Tome-Sulmont/docs-site/README.md

# Tomé Docs

Here is my documentation website where I share the various projects I am working on.

[docs.tomesulmont.com](https://docs.tomesulmont.com/)

I write my documentation with [Obsidian](https://obsidian.md/) and use [Quartz 4](https://quartz.jzhao.xyz/) to publish it.
