Tome-Sulmont/docs-site/content/B4 Adapter Project/Related Pages/Lens Pinout.md

---
draft: false
---

| B4 lens pinout | Female 12 pin HIROSE |
| :--- | --- |
| `1` RET switch<br>`2` VTR trigger<br>`3` GND<br>`4` Lens Auto/Manual control<br>`5` Iris control<br>`6` +12 V DC<br>`7` Iris position<br>`8` Iris A/R input<br>`9` Extender (doubler) position<br>`10` Zoom position<br>`11` ---<br>`12` --- | ![[HIROSE_12pin_connector_only.jpg\|12 pin hirose connector pinout\|260]] |

>**Note:**
>The pinout is standard for all manufacturers (Fujinon and Canon)

Source: [SteadicamForum](https://steadicamforum.com/index.php?app=forums&module=forums&controller=topic&id=151)
