Tome-Sulmont/docs-site/content/index.md

---
title: Welcome
description: Documentation of my camera, optics and maker projects. From adapting B4 broadcast lenses, to gear repairs and DIY builds.
draft: false
---
On this website, I share the various projects I am working on. 

## Projects
>### [[B4 Adapter Documentation]]
>A detailed guide on how to make an optically corrected adapter that lets 2/3" B4 broadcast lenses work on Sony, Nikon, Canon, Fujifilm and Lumix mirrorless cameras.

## Repairs
>### [[Zoom F6 NP-F Replacement]]
>A 3D-printable replacement for the Zoom F6 NP-F battery holder. STL and STEP files, as well as print settings, are included.
