Tome-Sulmont/docs-site/content/B4 Adapter Project/Tempo B4.md

---
draft: true
---
Local build :
```
npx quartz build --serve
```

GitHub deployment :
```
npx quartz sync
```

To Do :
- [x] Photo of the real adapter
- [ ] Voir B4-Adapter-Claude-Expertise pour améliorer
- [x] Photo of the rig
- [x] Assembly picks
- [x] increase the mount tol on the 3d
- [ ] Ironing (degrease tol ??)
- [x] Why adapting B4 broadcast glass in the first place ?
- [ ] Practical result
- [x] personal setups
- [x] r/Filmmakers, r/videography, r/DIY
- [ ] SD / HD lenses topic
- [x] Google indexation CEO -> *Automatic*
- [ ] ENG keyword
- [ ] Fuji HAF’s b4 cine lenses
- [ ] Comparison w/ and without the optical element

## Print advice section ?

As you know, every printer is different

I can't advise you enough to check if the tolerances are good by printing section of the part

Test you can do :

The bore hole that 
The circular alu
the size of the hole heat inserts

---
I'm a filmmaker. When I can't find the gear I need — or when it breaks — I build it, and I document how here. Everything on this site is something I made and actually use.
