Tome-Sulmont/docs-site/content/B4 Adapter Project/B4 Adapter Documentation.md

---
draft: false
description: Comprehensive guide on how to adapt 2/3" B4 ENG broadcast lenses to any mirrorless camera using corrective optics.
---

Here is a comprehensive guide on how to adapt 2/3" B4 broadcast lenses to any mirrorless camera using corrective optics. 

This adapter can be built for virtually any mounts available on the market (Sony, Nikon, Canon, Fujifilm, Lumix…) and can be made for relatively cheap compared to the off-the-shelf options available on the market.

## Context

B4 lenses are designed for use with 3-CCD sensors. In order to adapt them correctly to modern single-sensors, an optical element is required to correct [[Spherical Aberration]].

After quite a bit of research, I found that the [Blackmagic B4 mount](https://www.blackmagicdesign.com/products/blackmagicursaminipro/techspecs/W-URSA-22) for the URSA Mini can be found at a relatively low cost compared to the other [[Adapter options]] available to us.

The idea is to combine the Blackmagic B4 mount and a lens mount (salvaged from a lens adapter) with a 3D-printed part.

| ![[Blackmagic_URSA_mini_b4-mount.jpg\|Blackmagic URSA Mini B4 mount\|280]] | ![[Lens_mount_from_lens_adapter.jpg\|Lens mount from lens adapter\|110]] |
| :---: | :---: |
| *URSA Mini B4 mount* | *Lens adapter* |

See [[B4 Lens Nomenclature]] to learn about the naming system and how to choose the right B4 lens.
And see [[Why Adapting B4 Broadcast Lenses]] for a list of pro and cons of broadcast lenses.

## Capabilities

- APSC coverage (with the doubler engaged)
- `3.8x` crop factor (FF equivalent)
- No spherical aberration; the lens can be used wide open.

See [[Additional Information]] for more details.

## The Design

| ![[Final_adapter_front.jpg\|Custom adapter\|300]] | ![[Adapter_on_B4_lens_zoom.jpg\|Custom adapter mounted on a B4 lens\|300]] |
| :---: | :---: |
| *The final adapter* | *Here it is mounted on a B4 lens* |

### CAD

| ![[CAD_Assembly_with_balloon.png\|CAD isometric view\|340]] | ![[CAD_Assembly_section_view.png\|CAD section view\|235]] |
| :---: | :---: |
| *Isometric view* | *Side section view* |

➀ : URSA Mini B4 Mount [.STEP ↓](./B4-Adapter-Project/download/URSA-Mini-B4-Mount.STEP)
➁ : 3D-printed part [.STEP ↓](./B4-Adapter-Project/download/3d-printed-part.STEP)
③ : Aluminium lens mount [.STEP ↓](./B4-Adapter-Project/download/alu-lens-mount.STEP)

The [[Flange Distance]] of the URSA removable mount is 32.3mm. If you are interested, here is how I determined the [[URSA Removable Mount Flange Distance]].
I designed the part around this value and the different components listed in the BOM below.

## How to Build

### 3D Print the Part

Download the [.STL ↓](./B4-Adapter-Project/download/3d-printed-part.STL) , the [.STEP ↓](./B4-Adapter-Project/download/3d-printed-part.STEP) or directly the [.3MF ↓](./B4-Adapter-Project/download/3d-printed-part.3mf) file.

I printed the part in ASA on a Bambu Lab P1S printer.
Why ASA? Mainly for its UV and heat resistance, as well as its adequate mechanical properties.

Find all my [[Adapter Print Recommendations]] here.

### Bill of Materials

| Category | Item | Ref | Brand | Qty | Link |
| --- | --- | --- | --- | --- | --- |
| Mount (choose yours) | Leica M to **Fuji X** | LM-FX | PHOLSY | 1 | [Link](https://www.amazon.fr/PHOLSY-Adaptateur-objectifs-Leica-Appareil/dp/B0C9HVQCYR) |
| | Leica M to **Sony E** | LM-E | PHOLSY | 1 | [Link](https://www.amazon.fr/-/en/PHOLSY-Manual-Lens-Adapter-Compatible/dp/B0CYT475DR/) |
| | Leica M to **L mount**  | LM-L | PHOLSY | 1 | [Link](https://www.amazon.fr/-/en/PHOLSY-Adapter-Leica-Voigtlander-Compatible/dp/B0C9J2FF3T) |
| | Leica M to **Nikon Z**  | LM-N/Z | PHOLSY | 1 | [Link](https://www.amazon.fr/-/en/PHOLSY-Adapter-Compatible-Voigtlander-Cameras/dp/B0C16Y1WQF?th=1) |
| | Leica M to **MFT** | LM-MFT | PHOLSY | 1 | [Link](https://www.amazon.fr/-/en/Adapter-Leica-Cameras-Compatible-Panasonic/dp/B0C9HM25KZ) |
| | Leica M to **EOS-M** | LM-EOSM | PHOLSY | 1 | [Link](https://www.amazon.fr/-/en/Leica-Adapter-Compatible-Voigtlander-VM-Mount/dp/B0CJLNGM32) |
| | Leica M to **Canon RF** | LM-RF | PHOLSY | 1 | [Link](https://www.amazon.fr/-/en/PHOLSY-Adapter-Compatible-Leica-Voigtlander/dp/B0C16YNX2Z) |
| | | | | | |
| Corrected B4 adapter | URSA Mini B4 Mount | CINEURSAMUPROTB4HD | Blackmagic | 1 | [Link](https://www.blackmagicdesign.com/products/blackmagicursaminipro/techspecs/W-URSA-22) |
| | | | | | |
| Screws and bolts | M1.6 x 5mm Torx Screw | ISO14580 M1.6 x 5mm | | 4 | [Link](https://fr.aliexpress.com/item/1005005980400627.html) |
| | M1.6 Washer | DIN9021 M1.6 x 4 x 0.3 | | 4 | [Link](https://fr.aliexpress.com/item/1005007625630719.html) |
| | M2.5 Heat Insert | M2.5 x L4 x OD4 | | 5 | [Link](https://fr.aliexpress.com/item/1005008887061865.html) |
| | 1/4-20 Heat Insert | 1/4-20 x 6mm | | 2 | [Link](https://fr.aliexpress.com/item/1005008959101729.html) |

> **Disclaimers:** 
> Please note that the current design only works with the Leica M adapters listed above. 
> I have only tested the Fuji X and the Sony E version, but the design of all listed adapter is identical. So it should work with the other as well.

>**Tips to find the Blackmagic B4 adapter:** 
>Buy it from the second-hand market.
>Search the adapter by its reference *"CINEURSAMUPROTB4HD"*.

### Assembly

1. Print the part.

![[3D-Printed_part.jpg|3D-printed part|200]]

2. Remove the tree support. The surface is not functional but ensure no support material remains.

![[Remove_tree_support.jpg|Support material removal|200]]

3. Install the `x5` **M2.5 heat inserts** with a soldering iron. Be meticulous, the insert must be perfectly straight.

![[M2.5_heat_insert.jpg|M2.5 heat insert installation with a soldering iron|200]]

4. Repeat the operation with the `x2` **1/4-20 heat inserts**.

![[1_4-20_heat_insert.jpg|1/4-20 heat insert installation with a soldering iron|200]]

5. Disassemble the Leica M adapter and keep only the black coated aluminium mount.

![[Disassemble_Leica-M_adapter.jpg|Leica M adapter disassembly|400]]

6. Attach the aluminium mount to the printed part using `x4` **M1.6 screws and washers**. Align the red dot upward.

![[red_dot_up_cercle.jpg|Mirrorless mount orientation|200]] ![[Attach_the_aluminium_mount.jpg|Screwing the mirrorless mount in place|200]]

7. Remove the plastic protrusion on the side of the URSA Mini B4 mount.

8. Attach the URSA Mini B4 mount to the printed part using the included `x5` **M2.5 x 12 mm screws**. Align the notch upward (not necessarily the red dot).

![[noch_up_cercle.jpg|URSA B4 mount orientation|200]] ![[Attach_the_URSA_Mini_B4.jpg|Screwing the URSA B4 mount in place|200]]

9. The adapter is now complete.

![[Final_adapter_back.jpg|Completed adapter|200]]

## Lens / Adapter Support

The B4 mount is designed for use on heavy cameras, therefore, the connection between the lens and the adapter is extremely strong. 
However, mirrorless mounts are not designed to handle this amount of weight. 

### You have 3 options

1. **Hanging camera**
If you are using a mirrorless, the mount is strong enough to hang the camera from the mount. However, be careful: do not hold the grip of the camera to move the lens around, hold the lens instead. When using a tripod, mount the adapter directly to it.

2. **Solid connection**
Create a solid connection between the adapter and the camera body.
You can attach an Arca Swiss plate under the custom adapter. By using another Arca plate, 2 clamps and a 3D-printed riser, you can securely connect the adapter to the camera body.

3. **Lens support**
I've seen people online using lens supports and rods, this is another option.
Note that there is no need for an additional "lens support" as long as the adapter is strongly connected to the camera (option 2).

I use both Option 1 & 2 depending on the shoot. 
My current personal setup looks something like this :

| ![[personal_setup_solid_connection.jpg\|B4 ENG broadcast lens adapted on a mirrorless camera\|378]] | ![[solid_connection_only.jpg\|Custom adapter to camera body linkage\|294]] |
| :---: | :---: |
| *Option 2: solid connection* | *Plate, clamp and riser systeme* |

## Powering the rocker

The rocker on the side of the lens can be used to perform smooth and slow zooms. To use it, the rocker must be powered.
Pre-made cable exist but there are quite expensive. If you know how to make your own cable, it's worth it.

The cable attached to the lens use a male 12-pin HIROSE connector. You therefore need the female HIROSE connector and a 12 V power source. Use the pinout below to wire your cable.

### Female 12-pin HIROSE pinout

![[HIROSE_12pin_connector_only.jpg|12 pin hirose connector pinout|180]]
`3` = GND
`6` = +12 V DC

Because this information can be difficult to find, here is the detailed [[Lens Pinout]].

I advise you to buy the **female 12pin HIROSE** from AliExpress. They are available in both socket and plug version (make sur to select the female connector).

For the power source, you can use an NP-F battery plate that have a 12V output, such as those from SmallRig ([# 3018](https://www.smallrig.com/global/smallrig-np-f-battery-adapter-plate-lite-3018.html) or [# 3168B](https://www.smallrig.com/global/SmallRig-NP-F-Battery-Adapter-Mount-Plate-Advanced-Edition-3168B.html)). Alternatively you can use a D-Tap plug if you are using V-Lock batteries.

## Remaining Issues 

### Concentricity

The tolerances of the FDM 3D-printing process do not allow for "perfect" concentricity.
This can result in the lens not zooming perfectly to the center of the frame. In practice, this issue is barely noticeable and not disturbing in most cases. Just be aware this exists.

## Sample footages

If you want to see the adapter in action, check out my [[Canon J16ax8B4 Review]].

## Thanks

Thanks for reading this article, I hope you found some useful information.

I would love to discuss the topic and see if you're building one yourself.
