Tome-Sulmont/docs-site/content/B4 Adapter Project/Reddit post.md

---
draft: true
---

r/Filmmakers 
r/videography
r/VintageLenses
r/cinematography
r/VIDEOENGINEERING

# Reddit Adapter

### Custom B4 lens adapter for mirrorless cameras (with corrective optics)

Have you ever wondered how to adapt 2/3" B4 broadcast lenses to mirrorless camera?

Right now, you basically have two options: 
- Buy an insanely expensive corrected adapter
- Or use a simple pass-through adapter that forces you to stop the lens way down to avoid aberrations

But what if I told you there was a third option…

Jokes aside, for the past year and a half, I've spent way too much time designing a DIY adapter that works with any mirrorless mount currently available on the market (Sony, Nikon, Canon, Fujifilm & Lumix) — and, more importantly, includes the proper corrective optical element. 

The key idea is using the **URSA Mini B4 mount from Blackmagic** (which already contains the optical element) and adapting it mechanically to mirrorless mounts via a custom 3D-printed part and a metal mount.

I documented the entire process — optical considerations, flange distance measurements, 3D-printing, assembly, and more — here:

→ [B4 Adapter Documentation](https://docs.tomesulmont.com/B4-Adapter-Documentation)

I'd be more than happy to answer questions and hear your feedback :)

--- 

### Custom B4 lens adapter (with proper corrective optics)

Ever wondered how to properly adapt 2/3" B4 broadcast lenses to mirrorless cameras?

Your options today are either absurdly expensive corrected adapters, or a cheap pass-through adapter that forces you to stop down hard to avoid aberrations.

For the past year and a half, I've spent way too much time designing a third option: a DIY B4 adapter compatible with basically any mirrorless mount (Sony, Nikon, Canon, Fujifilm & Lumix).

The key idea is using the **URSA Mini B4 mount from Blackmagic** (which already contains the optical element) and adapting it mechanically to mirrorless mounts via a custom 3D-printed part and a metal mount.

I wrote a full guide covering the optics, measurements, 3D printing, and assembly. It might be useful if you’re into broadcast/ENG glass or love to adapt unique lenses.

→ [B4 Adapter Documentation](https://docs.tomesulmont.com/B4-Adapter-Documentation)

I will be more than happy to answer questions and hear your feedback :)

---

# Reddit Canon J16ax8B4

### Testing a B4 Lens on a Mirrorless Camera (Sample Images)
### What a B4 Broadcast Lens Looks Like on a Mirrorless Camera

I recently shared my custom B4 broadcast lens adapter [here](https://www.reddit.com/r/videography/comments/1qxd3kj/comment/o4511nf/), and several people asked to see **sample images** captured with it. 

I conducted some tests and created an article that includes interactive viewers allowing you to directly compare different apertures and focal lengths.

You can find my test of the Canon J16ax8B4 lens here:

→ [Canon J16ax8B4 Review](https://docs.tomesulmont.com/Canon-J16ax8B4-Review)

I’m trying to build the kind of resource I wish had existed when I first got interested in B4 lenses.  

I’d love to hear your feedback :)

**PS:** Yes, some tests were done in my bathroom. I needed the length of the corridor plus the bathroom.

---

Disclaimer: this is still an option that cost some money and some manufacturing knowledge

The few component needed can be found for cheap on AliExpress.
The main issue is sourcing the URSA B4 mount. I found mind on the second hand market; you can also search it by its reference "CINEURSAMUPROTB4HD" you may found cheaper resellers.

This isn’t meant to replace commercial solutions, but it can makes working with B4 glass on mirrorless bodies far more accessible.

Tell me what you thinks and want to see next :)

---

Hello documentary enthusiast, if you are interested in re-using your old B4 ENG/broadcast lenses, I designed a custom adapter for mirrorless mounts.

It uses a corrective optic from the URSA Mini B4 mount to deal with the lack of a 3-CCD prism.

I documented the entire making process if you're interested:
https://docs.tomesulmont.com/B4-Adapter-Documentation

Hello, I seen discussions about adapting B4 lenses here.

I designed a custom adapter for mirrorless mount. It uses a corrective optic from the URSA Mini B4 mount to deal with the lack of a 3-CCD prism.

I documented the entire making process if you're interested:
https://docs.tomesulmont.com/B4-Adapter-Documentation

It uses a corrective optic from the URRA Mini B4 mount to deal with the lack of 3-CCD prisme.
In combinaison with a metal mount and a 3d-printed part, it's create a relatively inexpensive option.
