Tome-Sulmont/docs-site/content/B4 Adapter Project/Related Pages/Spherical Aberration.md

---
draft: false
---

Lenses made for 3-CCD sensor focus different colours at different depths because the optical path of red, green and blue through the prisms is different. B4 lenses are designed to compensate for this effect.

Spherical aberration occurs when B4 optics are used with sensors using the Bayer filter.

| ![[Schematic_prism-based_3-CCD_sensor.jpg\|3-CCD sensor schematic\|340]] | ![[Bayer_matrix_sensor.jpg\|Sensor with Bayer filters chematic\|300]] |
| :---: | :---: |
| *3-CCD sensor schematic* | *Sensor w/ Bayer filter* |

Spherical aberration ≠ Chromatic aberration
Chromatic aberration is not corrected by the corrective optics (the green & purple fringing remains visible)

>**Note:**
>Engaging the doubler corrects some amount of spherical aberration, but not all of it.
