Tome-Sulmont/docs-site/content/B4 Adapter Project/Related Pages/Adapter options.md

---
draft: false
---

## My pick

- [Blackmagic URSA Mini B4 Mount](https://www.blackmagicdesign.com/products/blackmagicursaminipro/techspecs/W-URSA-22) (corrected x1.1)

## Other options that I came across (MFT, Sony E, PL, RED...)

- [KIPON B4 to PL S35](https://kipon.com/product/b4pl-s35/) (corrected x2.9)
- [Fotodiox Pro B4 to MFT](https://fotodioxpro.com/products/b4-magic) (corrected x1.4)
- [IB-E HDx35 B4 to PL](https://ibe-shop.com/products/hdx35-mark-iii-converter) (corrected)
- [Sony LA-EB1 B4 to E](https://pro.sony/en_ML/products/camera-lenses/la-eb1) (corrected)
- [MTF](https://mtfservices.com/collections/lens-adaptors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) offers a wide range of options (magnification only, no correction)
- [Zhongyi B4 to MFT](https://www.stkb.jp/shopdetail/000000001426/) (no correction x2)
- [Cinelux B4 to RED DSMC2](https://shop.cinelux.co.uk/products/b4-to-red-dsmc1-2-mount-adapter?_pos=1&_sid=8adc13e9a&_ss=r) (corrected x1.1)
- [Multicam B4 to MFT](https://www.multicam.systems/product/multicam-systems-b4-2-3-to-mft-adapter/) (corrected x1.1)

## James and Camera adapter

James and Camera is putting great content on B4 optics.
He has tested a lot of B4 lens (with and without corrected adaptors).
He is also selling a B4 adapter to various mount (Sony E, PL…).

Source: [James and Camera channel](https://www.youtube.com/@jamesandcamera)
