Tome-Sulmont/docs-site/content/B4 Adapter Project/Related Pages/Reddit post.md

---
draft: true
---

# Custom B4 lens adapter for mirrorless cameras (with corrective optics)

Have you ever wondered how to adapt 2/3" B4 broadcast lenses to mirrorless camera?

Right now, you basically have two options: 
- Buy an insanely expensive corrected adapter
- Or use a simple pass-through adapter that forces you to stop the lens way down to avoid aberrations

But what if I told you there was a third option…

Jokes aside, for the past year and a half, I've spent way too much time designing a DIY adapter that works with any mirrorless mount currently available on the market (Sony, Nikon, Canon, Fujifilm & Lumix) — and, more importantly, includes the proper corrective optical element. 

The key idea is using the **URSA Mini B4 mount from Blackmagic** (which already contains the optical element) and adapting it mechanically to mirrorless mounts via a custom 3D-printed part and a metal mount.

I documented the entire process — optical considerations, flange distance measurements, 3D-printing, assembly, and more — here:

→ [B4 Adapter Documentation](https://docs.tomesulmont.com/B4-Adapter-Documentation)

I'd be more than happy to answer questions and hear your feedback :)

--- 

# Custom B4 lens adapter (with proper corrective optics)

Ever wondered how to properly adapt 2/3" B4 broadcast lenses to mirrorless cameras?

Your options today are either absurdly expensive corrected adapters, or a cheap pass-through adapter that forces you to stop down hard to avoid aberrations.

For the past year and a half, I've spent way too much time designing a third option: a DIY B4 adapter compatible with basically any mirrorless mount (Sony, Nikon, Canon, Fujifilm & Lumix).

The key idea is using the **URSA Mini B4 mount from Blackmagic** (which already contains the optical element) and adapting it mechanically to mirrorless mounts via a custom 3D-printed part and a metal mount.

I wrote a full guide covering the optics, measurements, 3D printing, and assembly. It might be useful if you’re into broadcast/ENG glass or love to adapt unique lenses.

→ [B4 Adapter Documentation](https://docs.tomesulmont.com/B4-Adapter-Documentation)

I will be more than happy to answer questions and hear your feedback :)

---

r/Filmmakers (more serious than r/videography)
r/VintageLenses
r/cinematography
r/VIDEOENGINEERING

To Do :
- [x] Photo of the real adapter
- [x] Photo of the rig
- [x] Assembly picks
- [x] increase the mount tol on the 3d
- [ ] Ironing (degrease tol ??)
- [x] Why adapting B4 broadcast glass in the first place ?
- [ ] Practical result
- [ ] personal setups ??
- [ ] r/Filmmakers, r/videography, r/DIY
- [ ] SD / HD lenses topic
- [ ] Google indexation CEO
- [ ] ENG keyword
- [ ] Fuji HAF’s b4 cine lenses

---

Disclaimer: this is still an option that cost some money and some manufacturing knowledge

The few component needed can be found for cheap on AliExpress.
The main issue is sourcing the URSA B4 mount. 
I found mind on the second hand market; you can also search it by its reference "CINEURSAMUPROTB4HD" you may found cheaper resellers.

This isn’t meant to replace commercial solutions, but it can makes working with B4 glass on mirrorless bodies far more accessible.

![[personal_setup_solid_connection.jpg|500]]

![[Final_adapter_front.jpg|300]]

![[Adapter_on_B4_lens_zoom.jpg|300]]
![[CAD_Assembly_with_balloon.png|300]]
![[CAD_Assembly_section_view.png|300]]
