Tome-Sulmont/docs-site/content/B4 Adapter Project/attachments/1_4-20_heat_insert.jpg

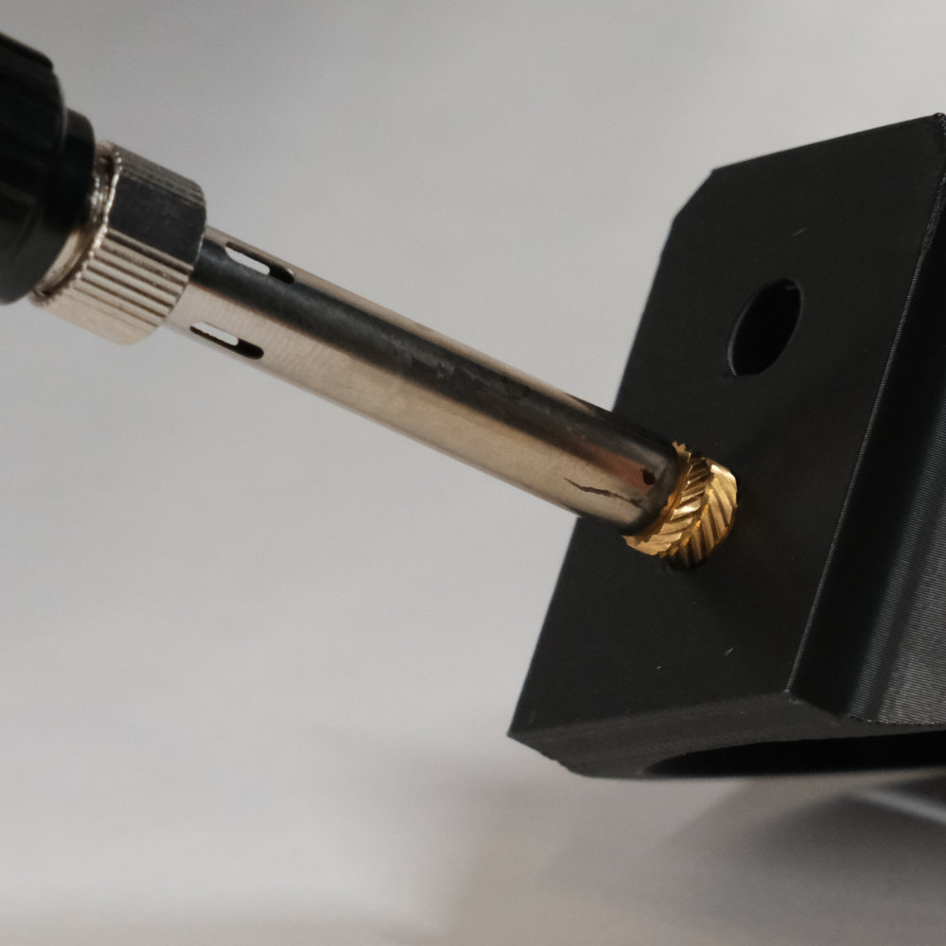
content/B4 Adapter Project/attachments/1_4-20_heat_insert.jpg
