Tome-Sulmont/docs-site/content/B4 Adapter Project/attachments/2_3inch_APSC_coverage.png

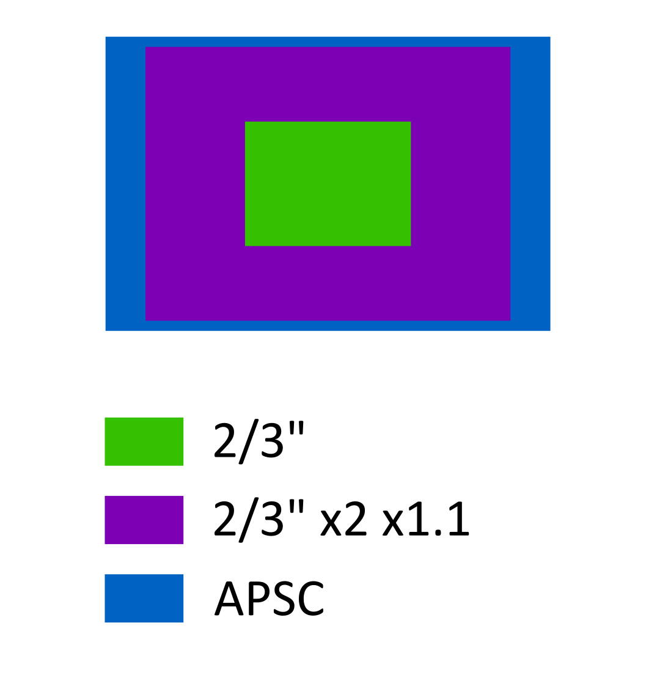
content/B4 Adapter Project/attachments/2_3inch_APSC_coverage.png
