Tome-Sulmont/docs-site/content/B4 Adapter Project/attachments/Adapter_on_B4_lens.jpg

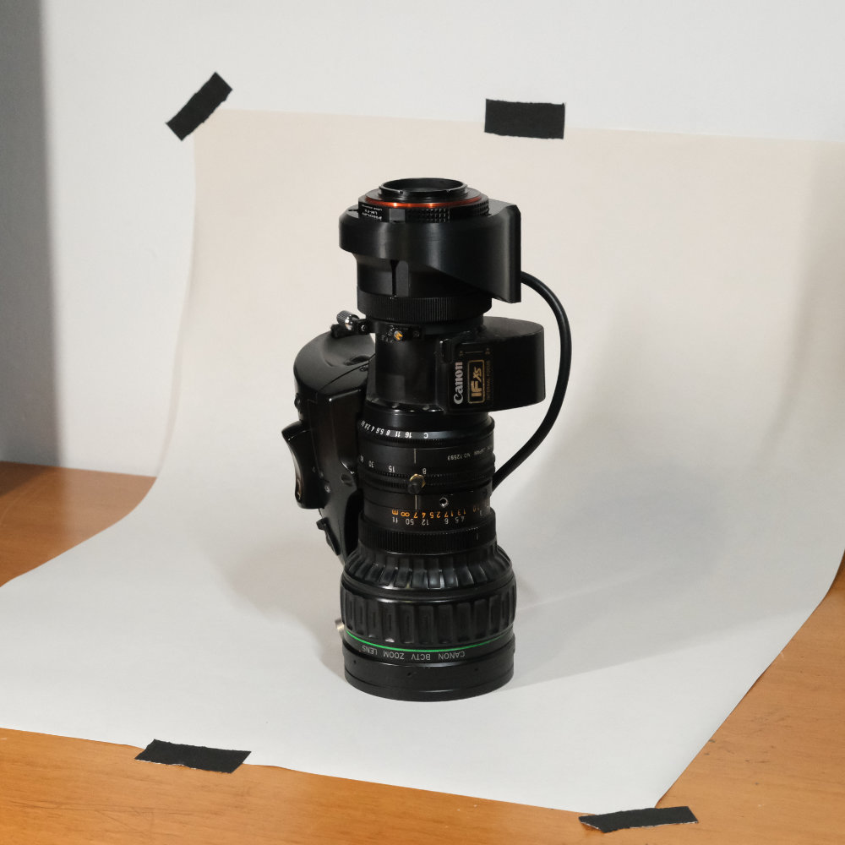
content/B4 Adapter Project/attachments/Adapter_on_B4_lens.jpg
