Tome-Sulmont/docs-site/content/B4 Adapter Project/attachments/Adapter_on_B4_lens_zoom.jpg

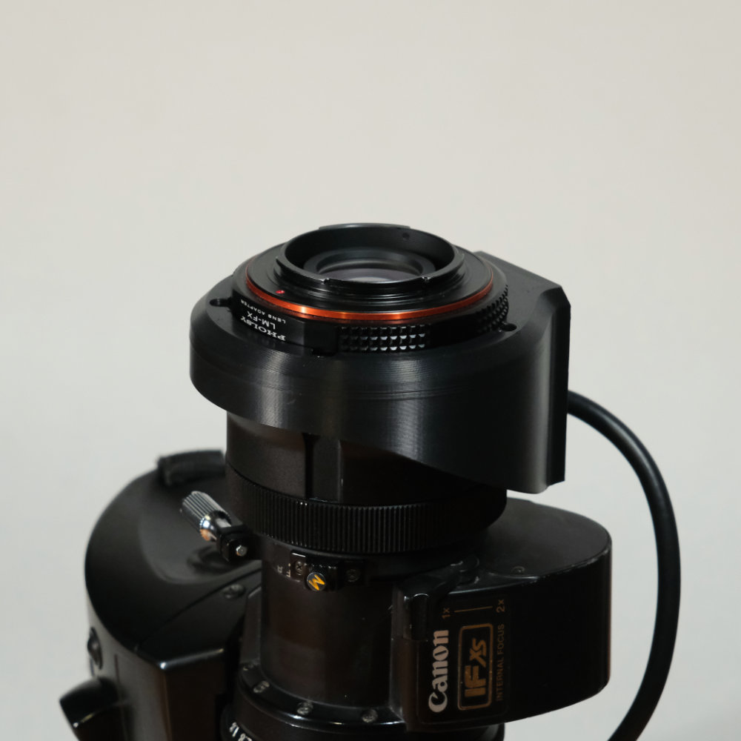
content/B4 Adapter Project/attachments/Adapter_on_B4_lens_zoom.jpg
