Tome-Sulmont/docs-site/content/B4 Adapter Project/attachments/Attach_the_aluminium_mount.jpg

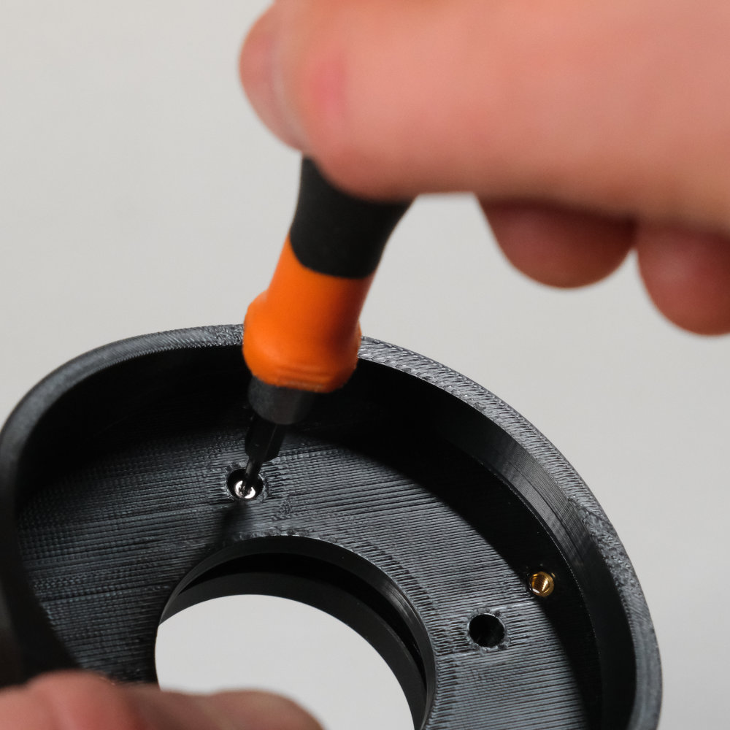
content/B4 Adapter Project/attachments/Attach_the_aluminium_mount.jpg
