Tome-Sulmont/docs-site/content/B4 Adapter Project/attachments/Attach_the_URSA_Mini_B4.jpg

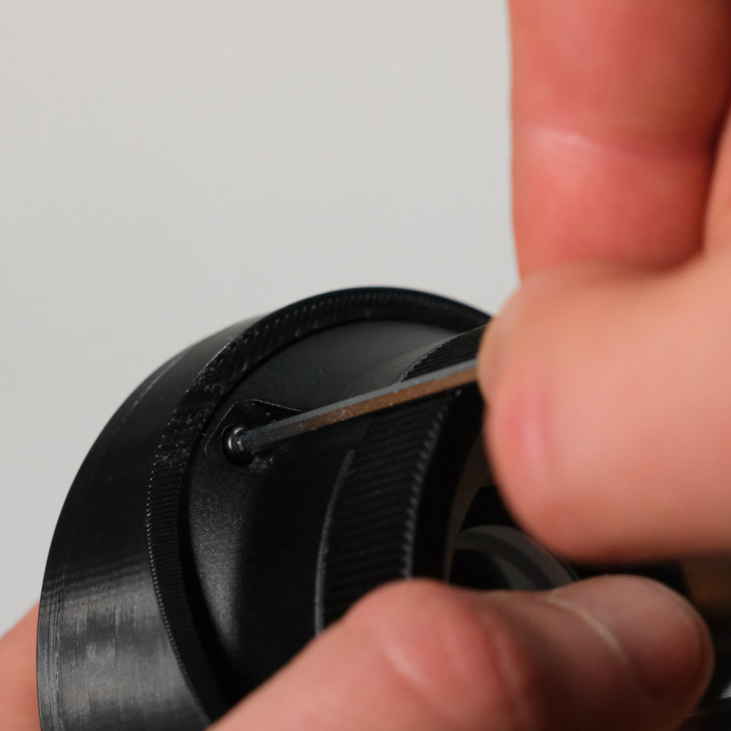
content/B4 Adapter Project/attachments/Attach_the_URSA_Mini_B4.jpg
