Tome-Sulmont/docs-site/content/B4 Adapter Project/attachments/Bayer_matrix_sensor.jpg

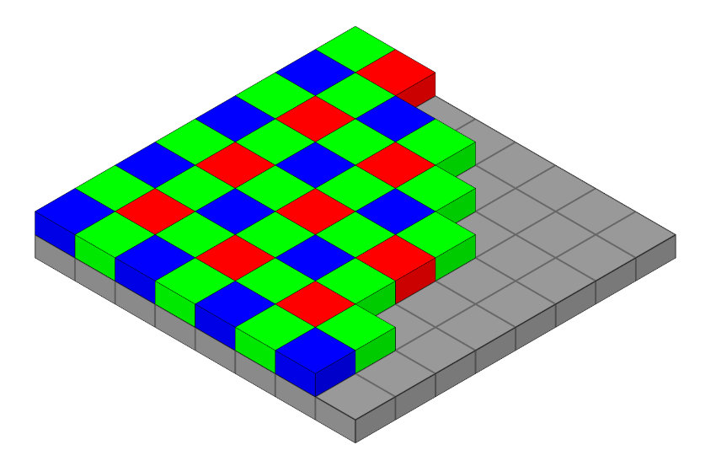
content/B4 Adapter Project/attachments/Bayer_matrix_sensor.jpg
