Tome-Sulmont/docs-site/content/B4 Adapter Project/attachments/Blackmagic_URSA_mini_b4-mount.jpg

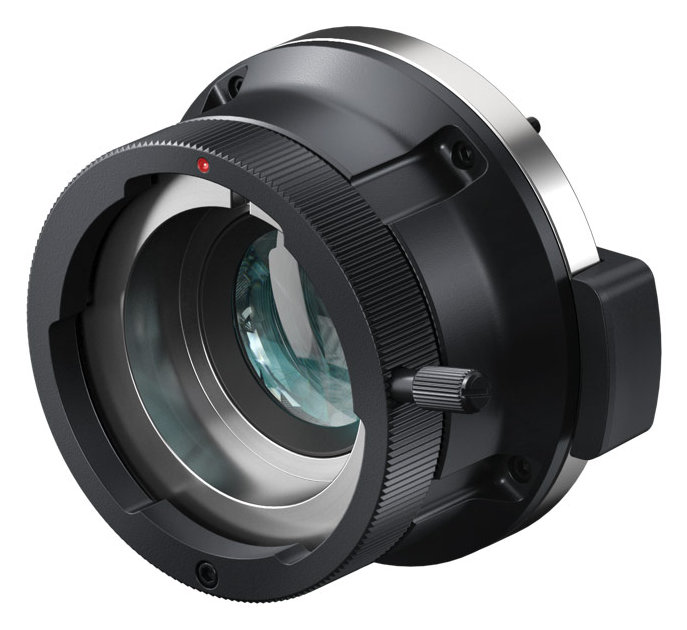
content/B4 Adapter Project/attachments/Blackmagic_URSA_mini_b4-mount.jpg
