Tome-Sulmont/docs-site/content/B4 Adapter Project/attachments/comparison/J16ax8B4-015mm-f1.8-x1-S16.jpg

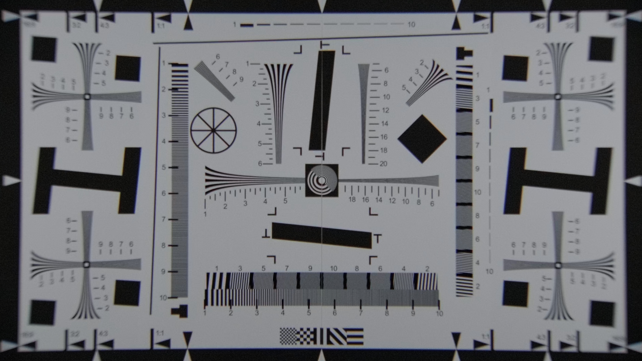
content/B4 Adapter Project/attachments/comparison/J16ax8B4-015mm-f1.8-x1-S16.jpg
