Tome-Sulmont/docs-site/content/B4 Adapter Project/attachments/comparison/J16ax8B4-030mm-f4.0-x2-APSC.jpg

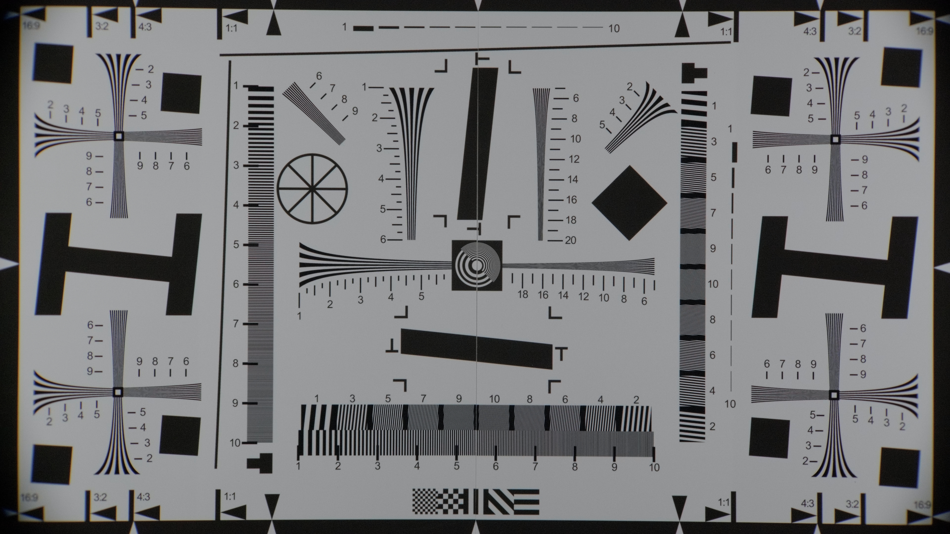
content/B4 Adapter Project/attachments/comparison/J16ax8B4-030mm-f4.0-x2-APSC.jpg
