Tome-Sulmont/docs-site/content/B4 Adapter Project/attachments/comparison/J16ax8B4-060mm-f5.6-x2-APSC.jpg

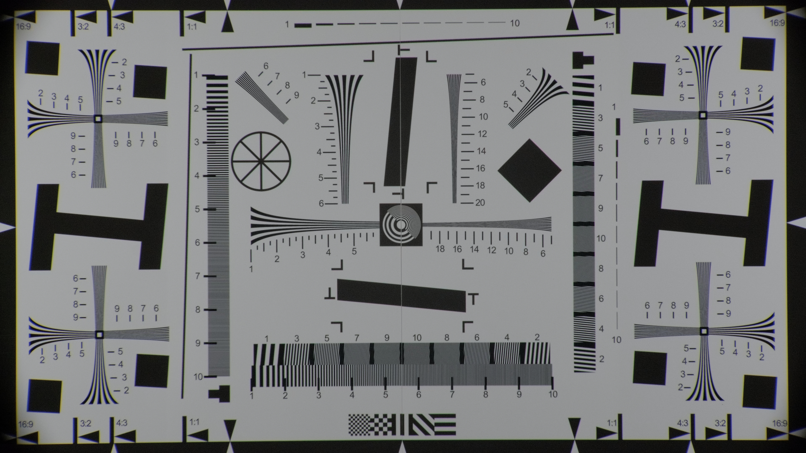
content/B4 Adapter Project/attachments/comparison/J16ax8B4-060mm-f5.6-x2-APSC.jpg
