Tome-Sulmont/docs-site/content/B4 Adapter Project/attachments/DSCF0033.jpg

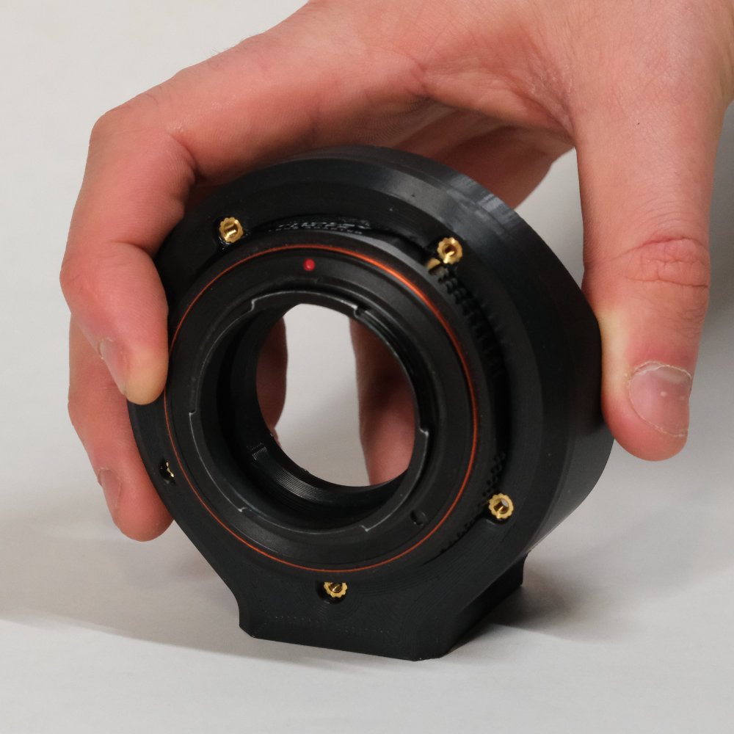
content/B4 Adapter Project/attachments/DSCF0033.jpg
