Tome-Sulmont/docs-site/content/B4 Adapter Project/attachments/Flange_distance_on_Blackmagic_B4.png

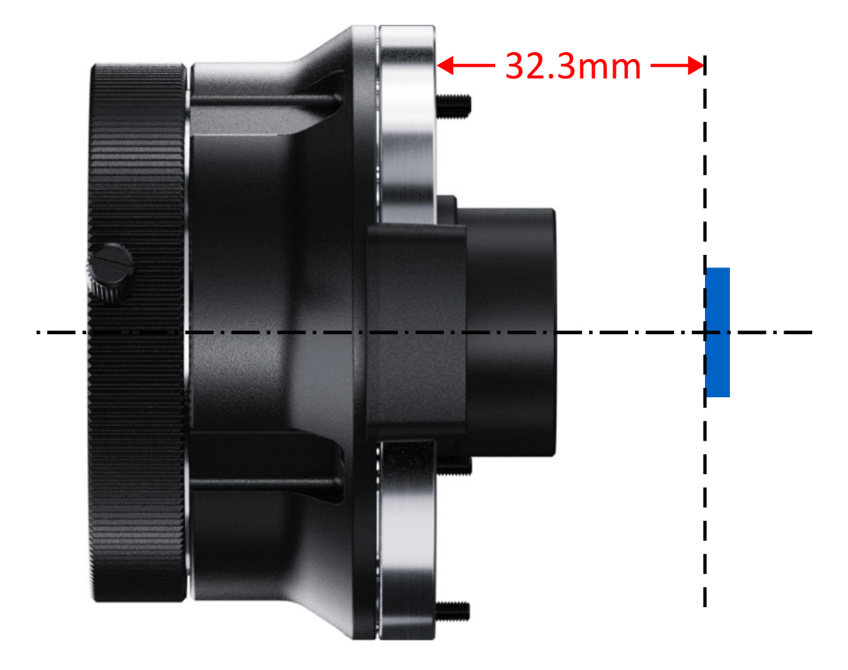
content/B4 Adapter Project/attachments/Flange_distance_on_Blackmagic_B4.png
