Tome-Sulmont/docs-site/content/B4 Adapter Project/attachments/Fuji_lens_model_num.jpg

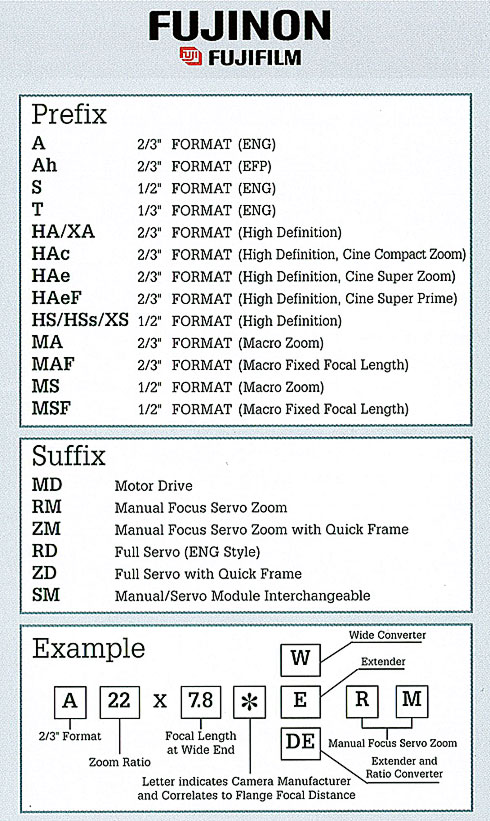
content/B4 Adapter Project/attachments/Fuji_lens_model_num.jpg
