Tome-Sulmont/docs-site/content/B4 Adapter Project/attachments/High resolution/Chart-wide.jpg

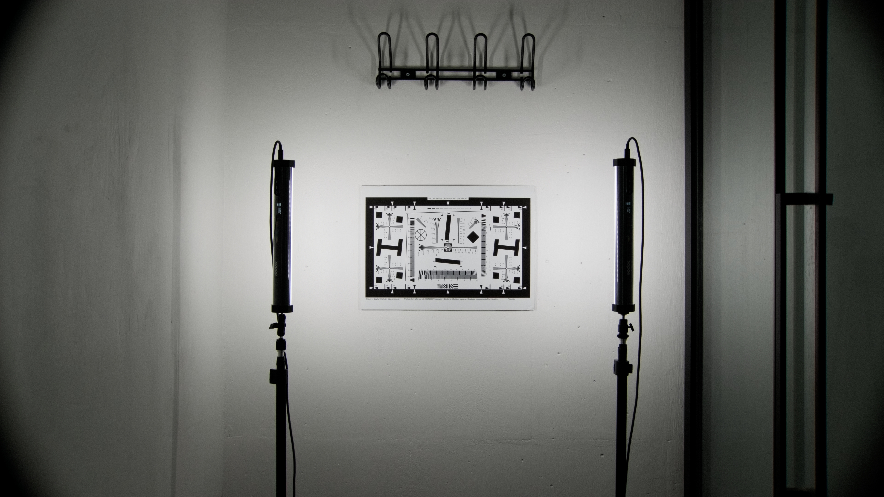
content/B4 Adapter Project/attachments/High resolution/Chart-wide.jpg
