Tome-Sulmont/docs-site/content/B4 Adapter Project/attachments/High resolution/Chart-zoom.jpg

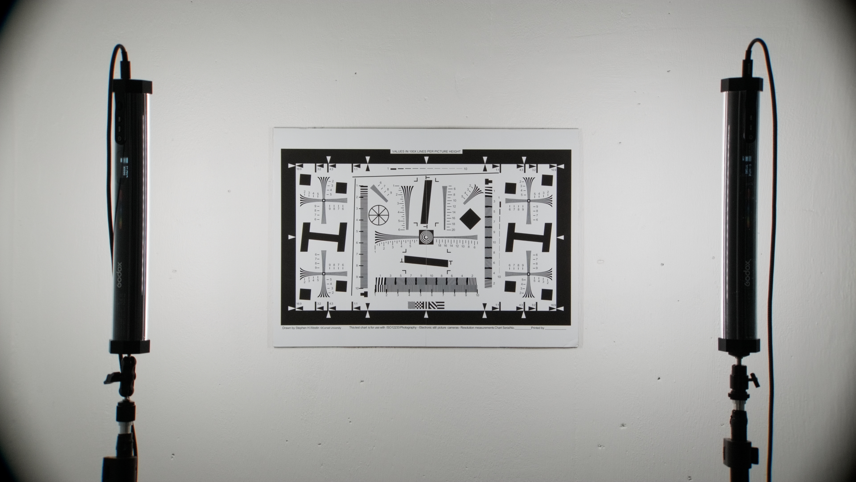
content/B4 Adapter Project/attachments/High resolution/Chart-zoom.jpg
