Tome-Sulmont/docs-site/content/B4 Adapter Project/attachments/High resolution/Crash-zoom.jpg

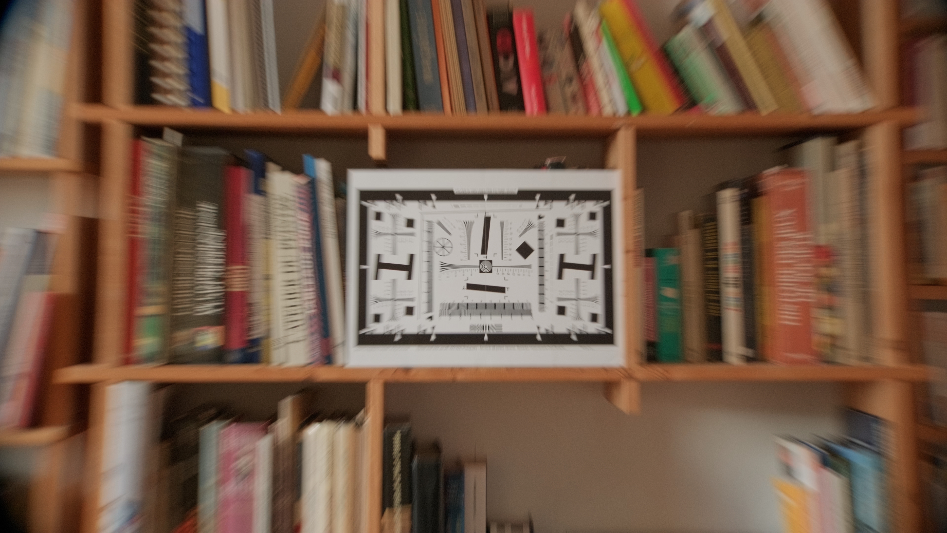
content/B4 Adapter Project/attachments/High resolution/Crash-zoom.jpg
