Tome-Sulmont/docs-site/content/B4 Adapter Project/attachments/High resolution/Final_adapter_front_hd.jpg

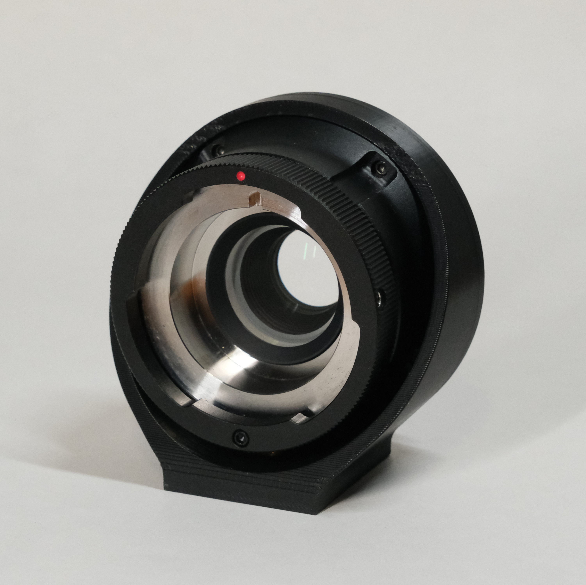
content/B4 Adapter Project/attachments/High resolution/Final_adapter_front_hd.jpg
