Tome-Sulmont/docs-site/content/B4 Adapter Project/attachments/HIROSE_12pin_connector_only.jpg

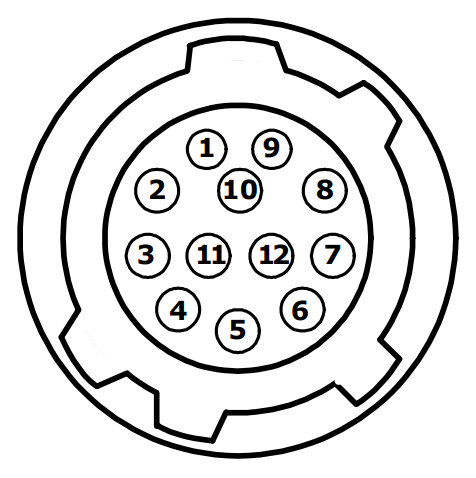
content/B4 Adapter Project/attachments/HIROSE_12pin_connector_only.jpg
