Tome-Sulmont/docs-site/content/B4 Adapter Project/attachments/Lens_mount_from_lens_adapter.jpg

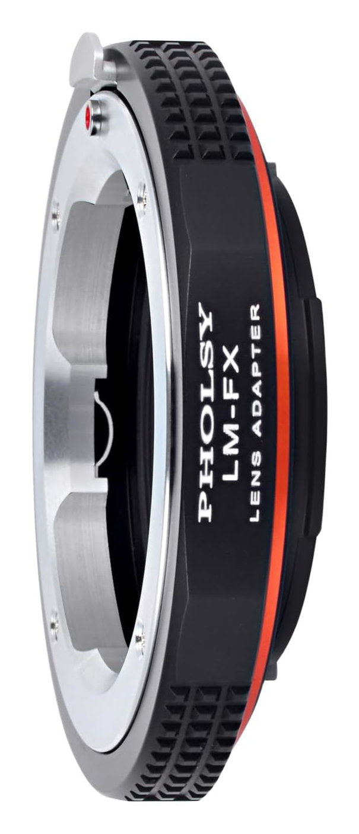
content/B4 Adapter Project/attachments/Lens_mount_from_lens_adapter.jpg
