Tome-Sulmont/docs-site/content/B4 Adapter Project/attachments/M2.5_heat_insert.jpg

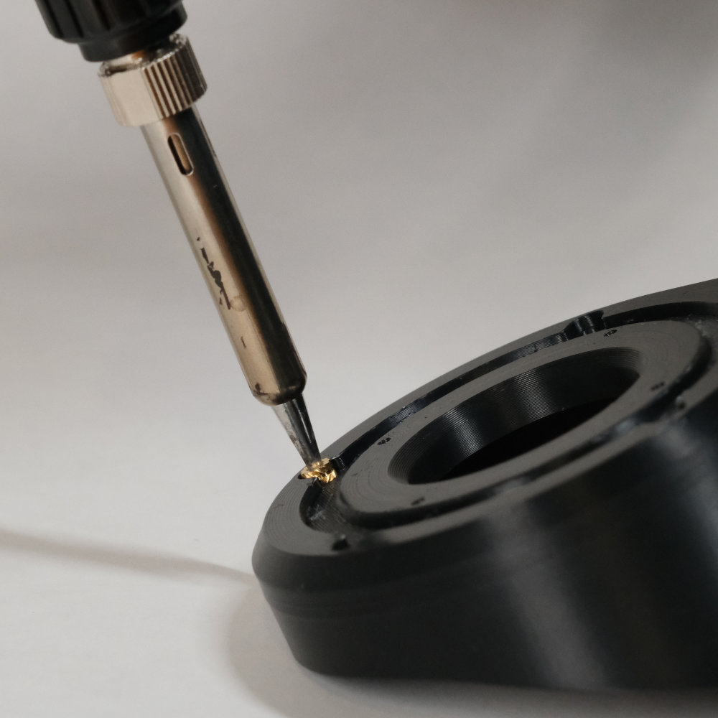
content/B4 Adapter Project/attachments/M2.5_heat_insert.jpg
