Tome-Sulmont/docs-site/content/B4 Adapter Project/attachments/noch_up_cercle.jpg

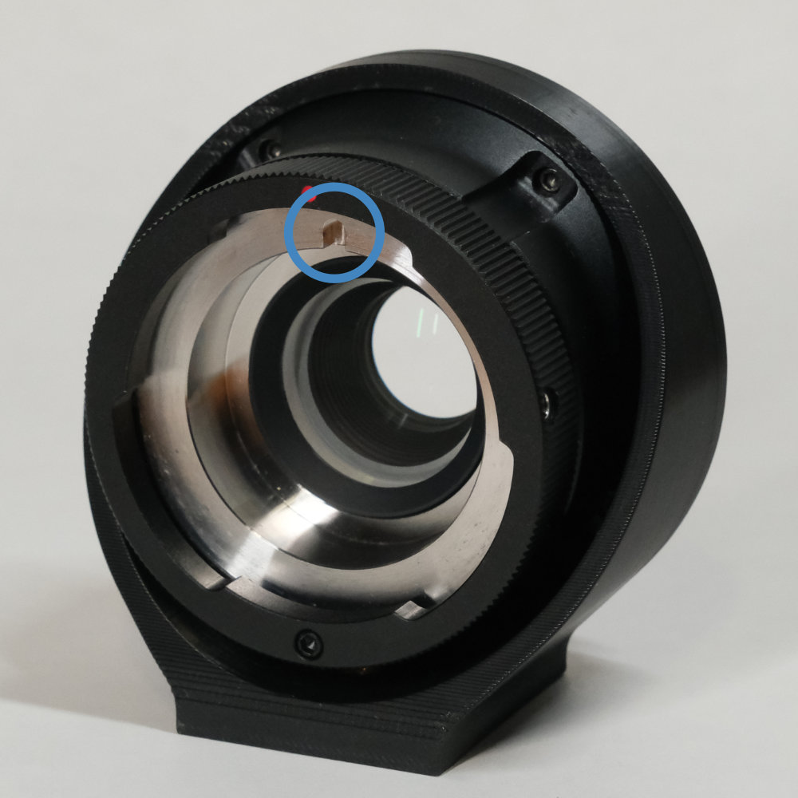
content/B4 Adapter Project/attachments/noch_up_cercle.jpg
