Tome-Sulmont/docs-site/content/B4 Adapter Project/attachments/red_dot_up_cercle.jpg

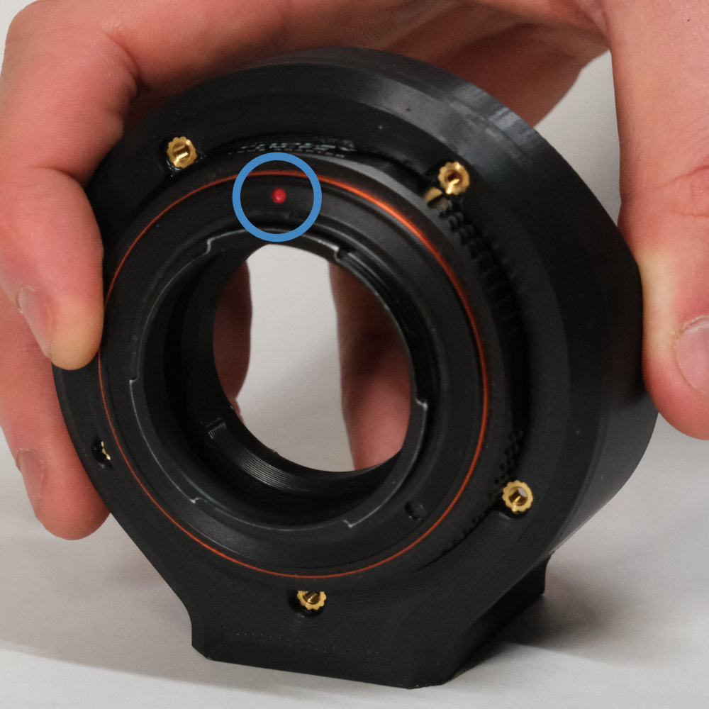
content/B4 Adapter Project/attachments/red_dot_up_cercle.jpg
