Tome-Sulmont/docs-site/content/B4 Adapter Project/attachments/Remove_tree_support.jpg

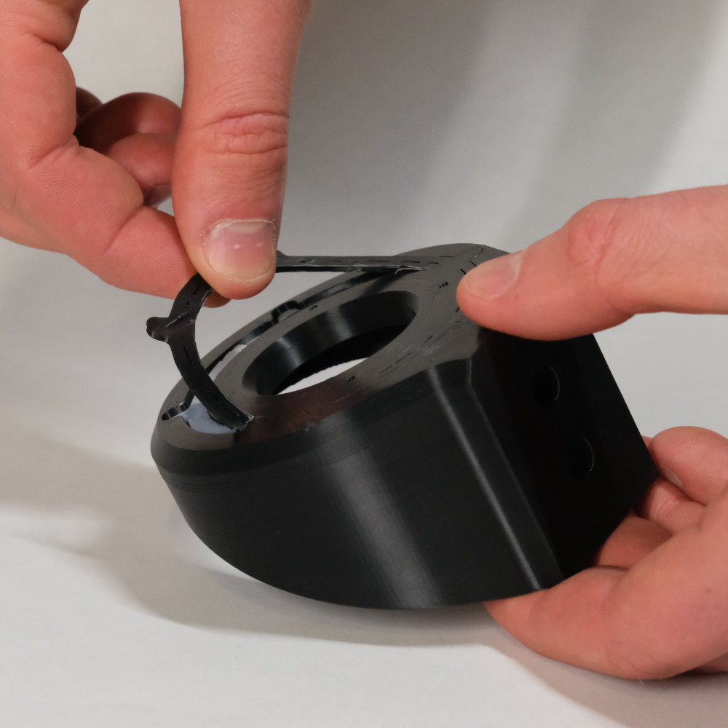
content/B4 Adapter Project/attachments/Remove_tree_support.jpg
