Tome-Sulmont/docs-site/content/B4 Adapter Project/attachments/Schematic_prism-based_3-CCD_sensor.jpg

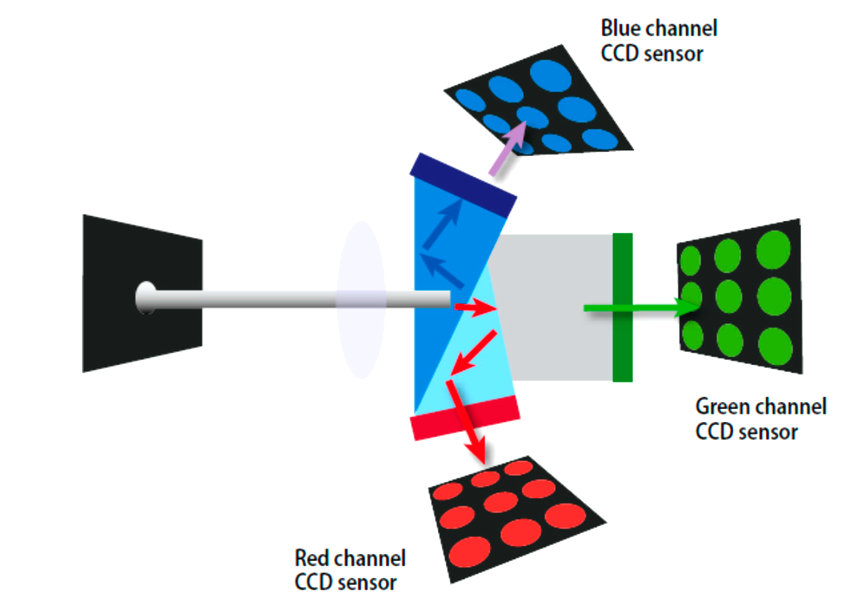
content/B4 Adapter Project/attachments/Schematic_prism-based_3-CCD_sensor.jpg
