Tome-Sulmont/docs-site/content/B4 Adapter Project/attachments/solid_connection_only.jpg

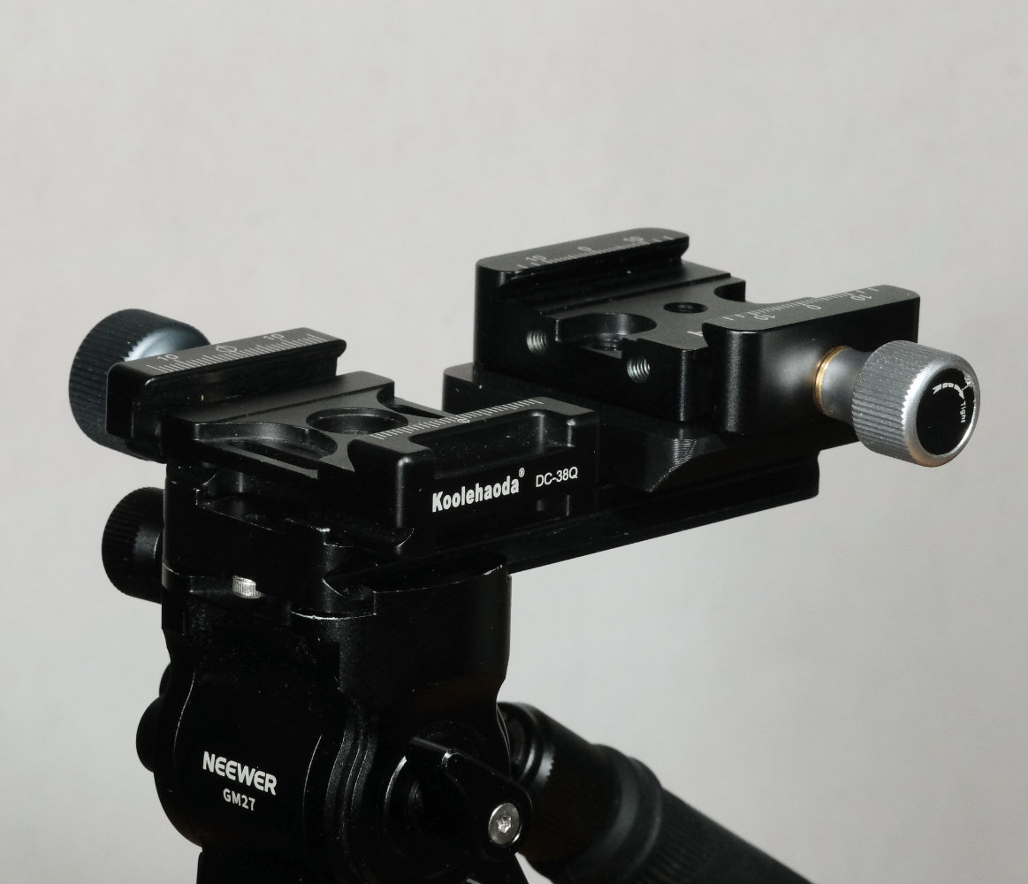
content/B4 Adapter Project/attachments/solid_connection_only.jpg
