Tome-Sulmont/docs-site/content/B4 Adapter Project/Related Pages/B4 Lens Nomenclature.md

---
draft: false
---

| Canon | Fujinon |
| --- | --- |
| ![[Canon_lens_model_num.jpg\|Canon broadcast lens nomenclature\|338]] | ![[Fuji_lens_model_num.jpg\|Fujinon broadcast lens nomenclature\|300]] |

Source: [Broadcast Lens Nomenclature - Abel Cine](https://www.abelcine.com/articles/blog-and-knowledge/tools-charts-and-downloads/broadcast-lens-nomenclature-key)

> **Advice:**
> Pick a 2/3" lens, 1/2" lenses have too small an image circle.
> Choose a lens with a doubler (`2x` extender) for APSC coverage.
