Tome-Sulmont/docs-site/content/REPAIRS/Zoom F6/download/Zoom-F6-NP-F-Replacement-Main.STL

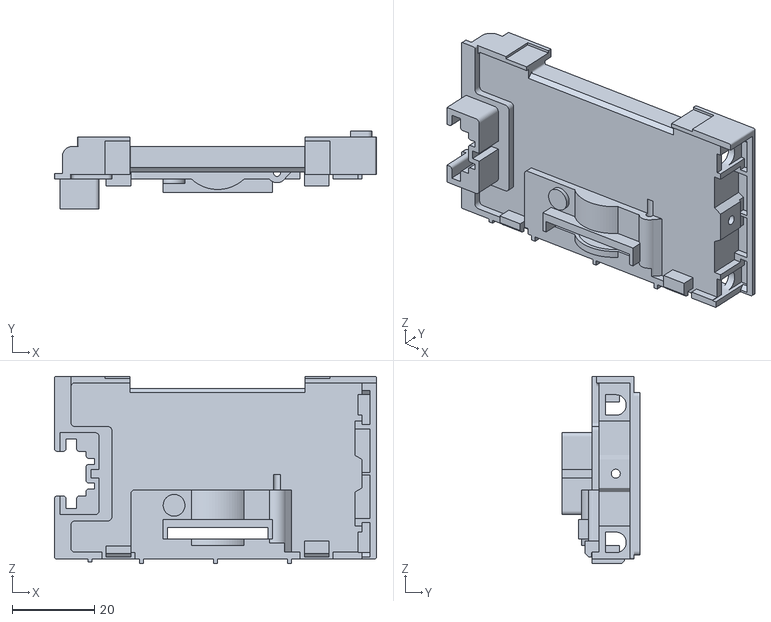
[picture p38: CAD file, 2026-06-29]
content/REPAIRS/Zoom F6/download/Zoom-F6-NP-F-Replacement-Main.STL
78.5 x 18.9 x 45.7
