Tome-Sulmont/docs-site/content/B4 Adapter Project/download/3d-printed-part.step.SLDPRT

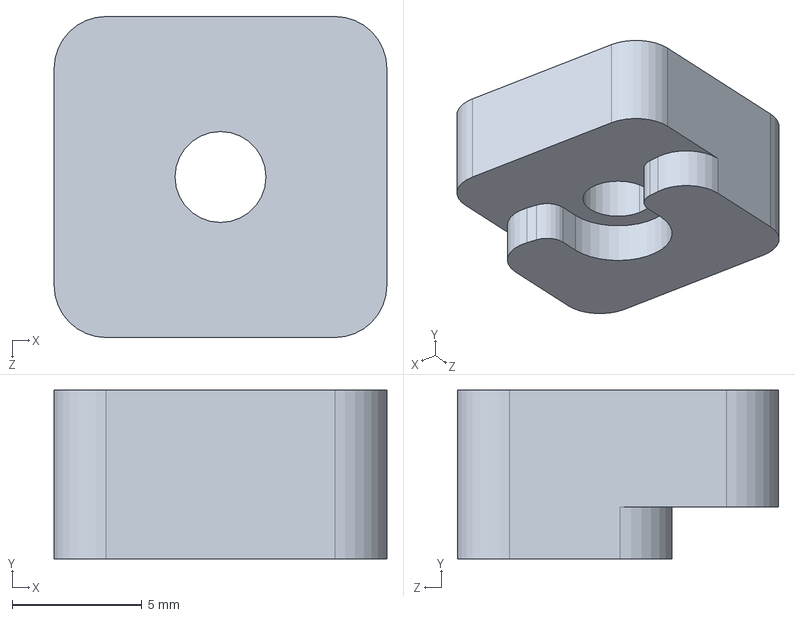
[picture p39: CAD file, 2026-02-09]
content/B4 Adapter Project/download/3d-printed-part.step.SLDPRT
12.8 x 6.50 x 12.3 mm
