Tome-Sulmont/docs-site/content/REPAIRS/Zoom F6/download/Zoom-F6-NP-F-Replacement.STEP

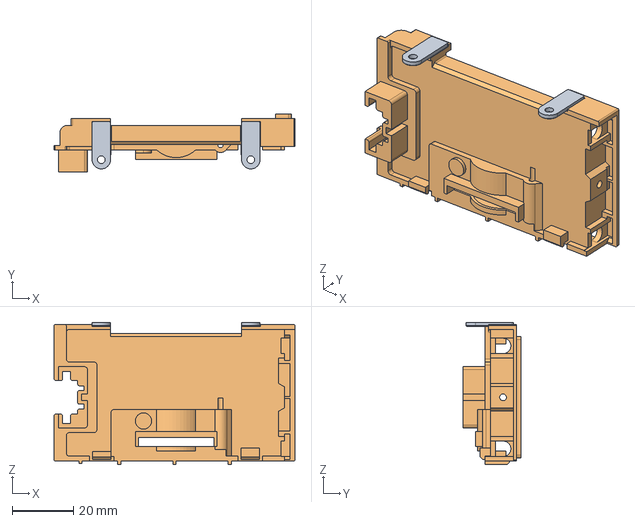
[picture p40: CAD file, 2026-06-29]
content/REPAIRS/Zoom F6/download/Zoom-F6-NP-F-Replacement.STEP
78.5 x 18.9 x 46.4 mm
