Tome-Sulmont/docs-site/content/B4 Adapter Project/download/alu-lens-mount.STEP

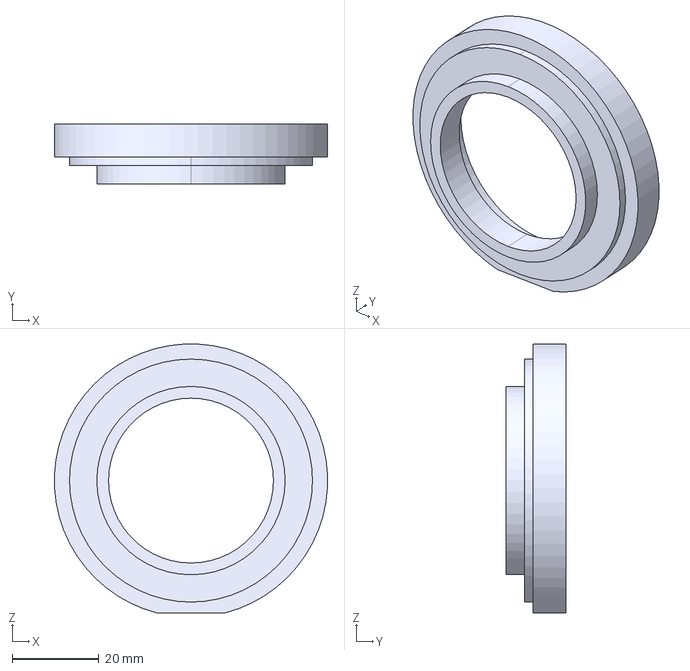
[picture p41: CAD file, 2026-02-02]
content/B4 Adapter Project/download/alu-lens-mount.STEP
62.9 x 13.8 x 62.0 mm
