Tome-Sulmont/docs-site/content/B4 Adapter Project/download/URSA-Mini-B4-Mount.STEP

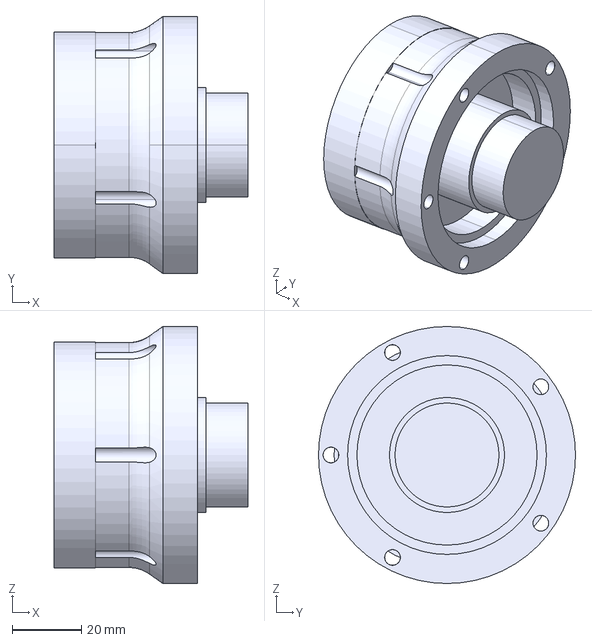
[picture p42: CAD file, 2026-02-02]
content/B4 Adapter Project/download/URSA-Mini-B4-Mount.STEP
56.0 x 74.2 x 74.2 mm
