Tome-Sulmont/docs-site/content/REPAIRS/Zoom F6/download/Zoom-F6-NP-F-Replacement-Tab.STL

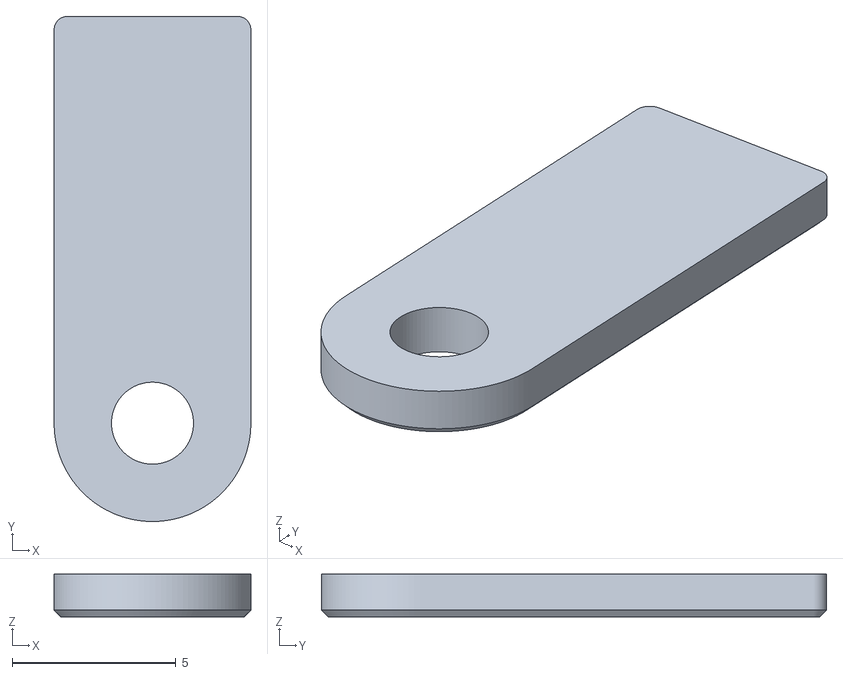
[picture p43: CAD file, 2026-06-29]
content/REPAIRS/Zoom F6/download/Zoom-F6-NP-F-Replacement-Tab.STL
6.00 x 15.4 x 1.30
