Tome-Sulmont/docs-site/content/B4 Adapter Project/download/3d-printed-part.STEP

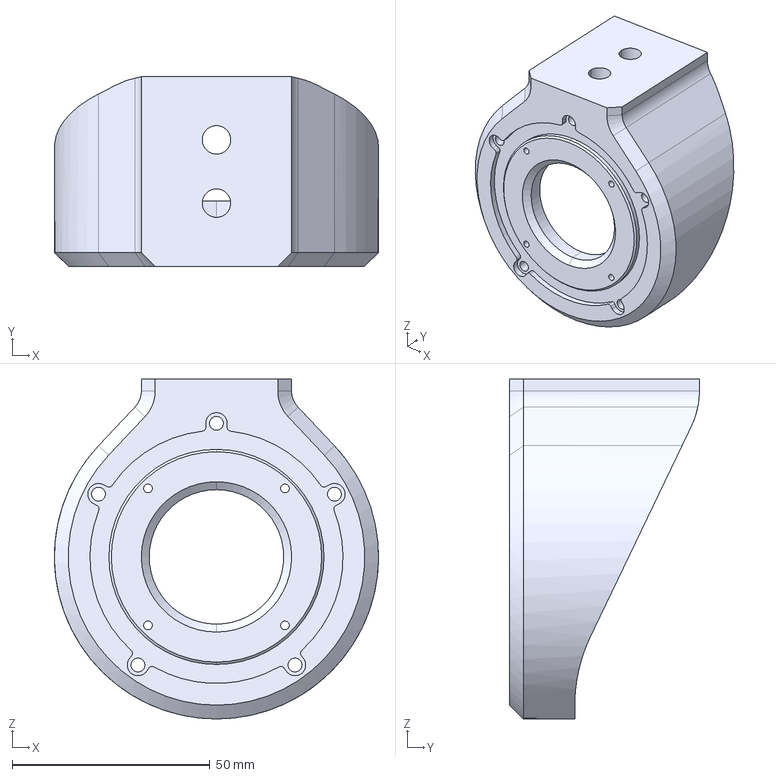
[picture p44: CAD file, 2026-02-02]
content/B4 Adapter Project/download/3d-printed-part.STEP
82.0 x 48.0 x 86.0 mm
