Tome-Sulmont/docs-site/(list of files, cad)

Other CAD files:
content/B4 Adapter Project/download/3d-printed-part.3mf
content/B4 Adapter Project/download/3d-printed-part.STL
content/REPAIRS/Zoom F6/download/Zoom-F6-NP-F-Replacement.3mf
