Tome-Sulmont/docs-site/content/B4 Adapter Project/attachments/CAD_Assembly_back.png

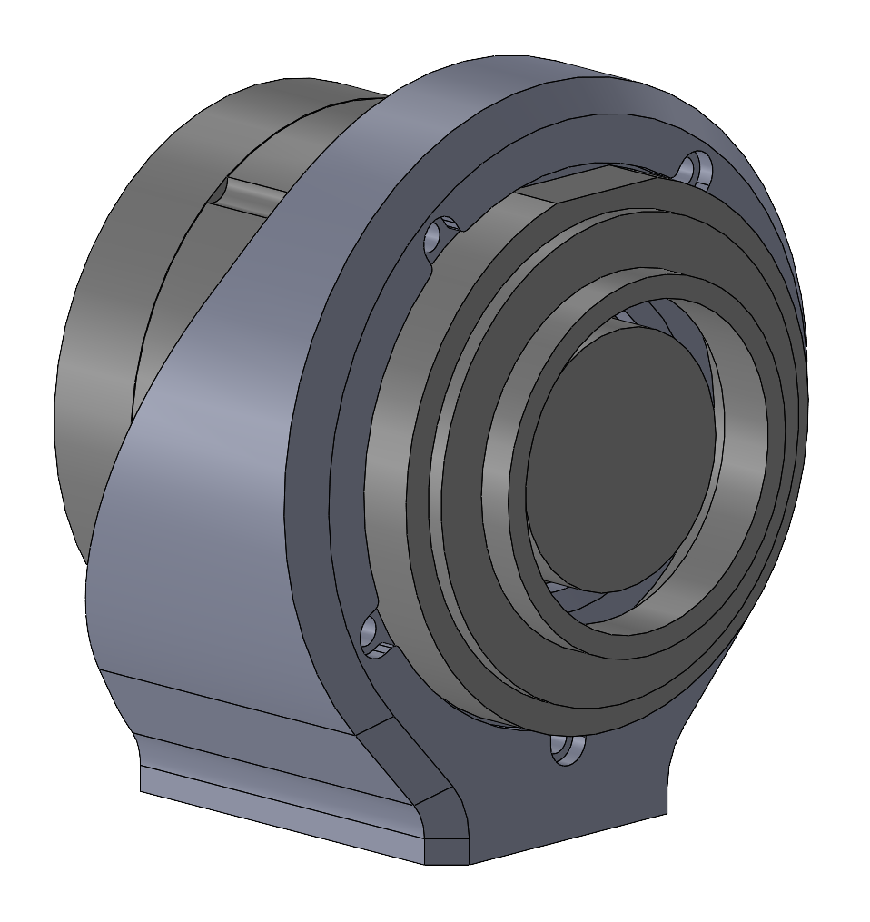
content/B4 Adapter Project/attachments/CAD_Assembly_back.png
