Tome-Sulmont/docs-site/content/B4 Adapter Project/attachments/CAD_Assembly_section_view.png

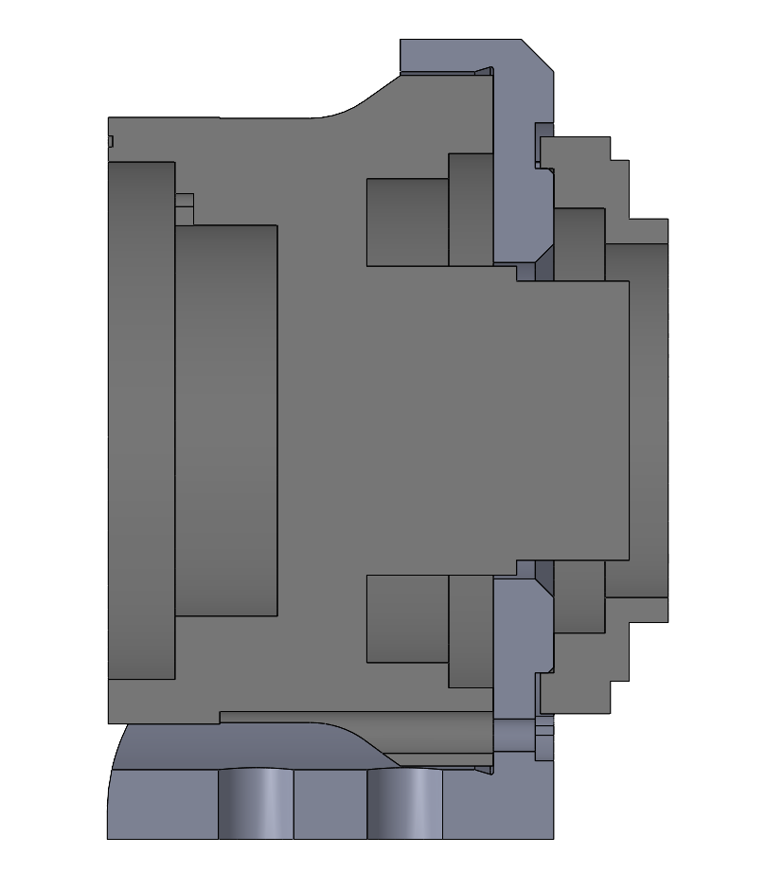
content/B4 Adapter Project/attachments/CAD_Assembly_section_view.png
