Tome-Sulmont/docs-site/content/B4 Adapter Project/attachments/CAD_Assembly_with_balloon.png

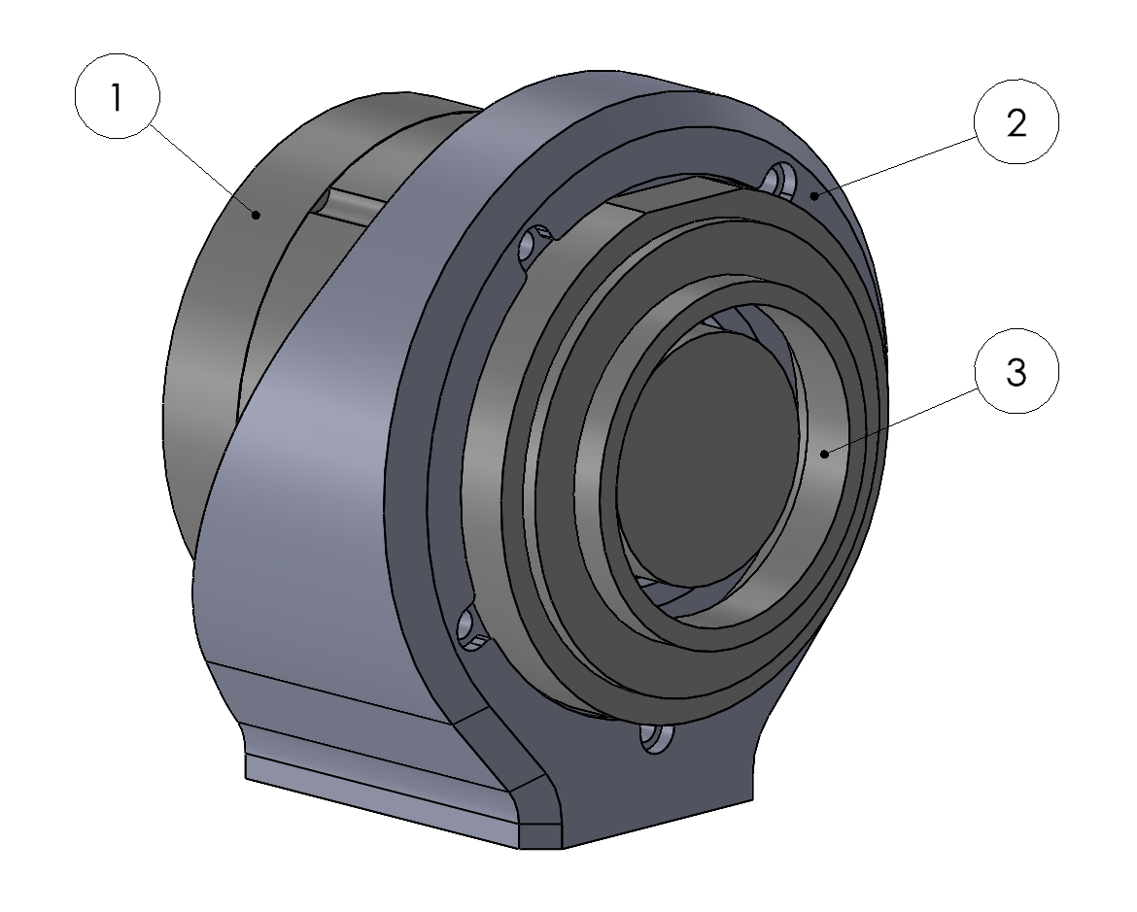
content/B4 Adapter Project/attachments/CAD_Assembly_with_balloon.png
