Tome-Sulmont/docs-site/content/B4 Adapter Project/attachments/Disassemble_Leica-M_adapter.jpg

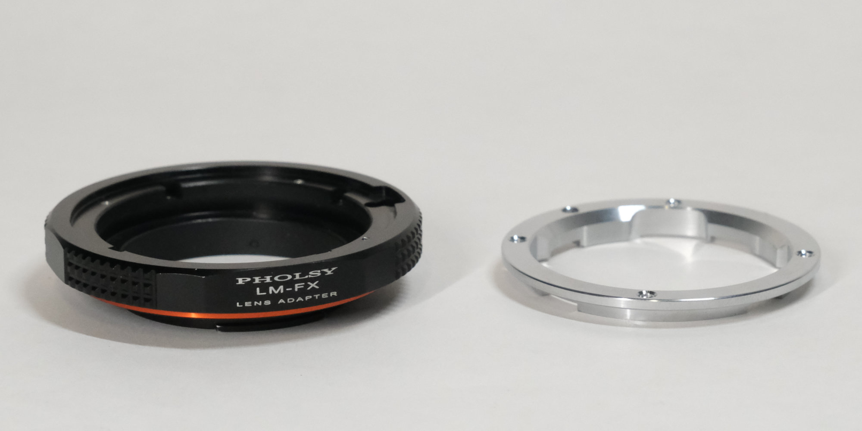
content/B4 Adapter Project/attachments/Disassemble_Leica-M_adapter.jpg
