Tome-Sulmont/docs-site/content/REPAIRS/Zoom F6/attachments/3d-printed-np-f-replacement-final.jpg

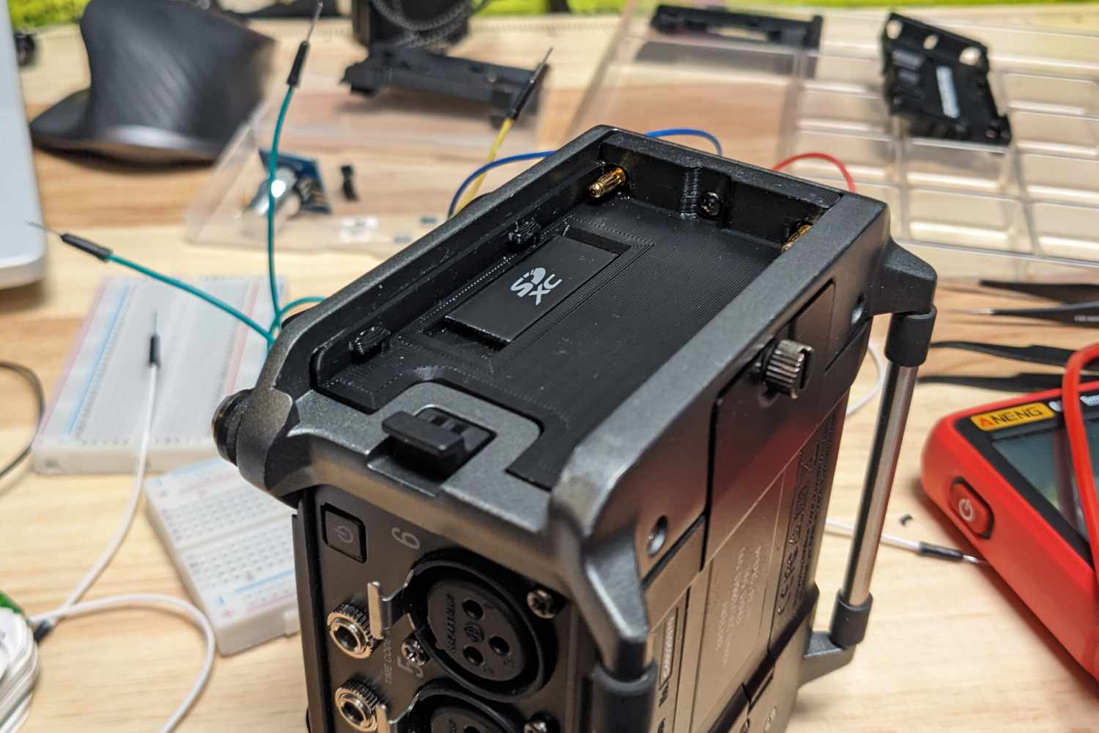
content/REPAIRS/Zoom F6/attachments/3d-printed-np-f-replacement-final.jpg
