Tome-Sulmont/docs-site/content/REPAIRS/Zoom F6/attachments/3d-printed-np-f-replacement-pcb.jpg

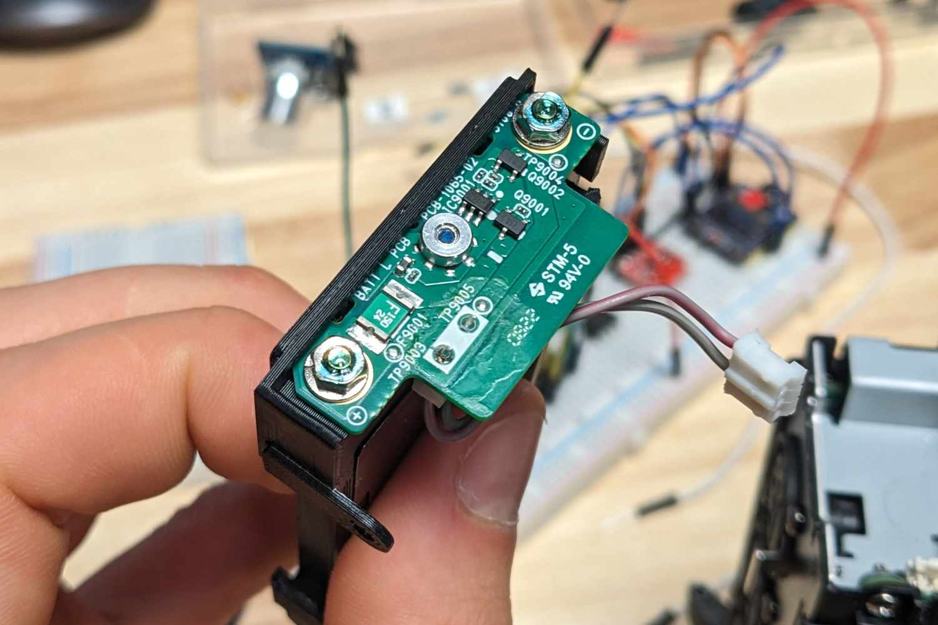
content/REPAIRS/Zoom F6/attachments/3d-printed-np-f-replacement-pcb.jpg
