Tome-Sulmont/docs-site/content/B4 Adapter Project/Related Pages/Canon J11ex4.5B Characteristics.md

---
draft: true
description:
---

Review of the Canon J11ex4.5B lens paired with the [Custom B4 adapter](/B4-Adapter-Documentation).

## Lens Characteristics

| Canon J11ex4.5B | |
| --- | --- |
| Focal length | 4.5-50mm → 17-185mm (FF eq.)  |
| Aperture | f1.8 4.5-36mm & f2.35 at 50mm |
| Weight | 1,83 kg |
| Doubler | Yes |
| Min focusing distance | 0.3m |
| Front filter diameter | no thread |

Complete datasheet: [.PDF ↓](./B4-Adapter-Project/download/Canon-J11ex4.5B-datasheet.pdf)
