Tome-Sulmont/docs-site/content/REPAIRS/Movi pro/Movi Pro Battery holder Replacement.md

---
draft: true
description: 3D-printable replacement housing for a broken Movi Pro battery holder.
---
## Intro
This page provides a 3D-printable replacement for the Movi Pro battery holder. The design replaces the original injection-molded part while reusing the original electronic.

| ![[3d-printed-np-f-replacement-final.jpg\|450]] |
| :---------------------------------------------: |
|         *The replacement part in place*         |

| ![[3d-printed-np-f-replacement-back.jpg\|450]] | ![[3d-printed-np-f-replacement-pcb.jpg\|450]] |
| :---: | :---: |
| *Rear of the replacement part* |  *Original NP-F PCB on the replacement part*  |

## CAD

| ![[zoom-f6-np-f-iso-view-top.png\|CAD isometric view\|450]] |
| :---------------------------------------------------------: |
|                    *CAD Isometric view*                     |

## Download

| Component | File |
| --- | --- |
| The part | [.STL ↓](./REPAIRS/Zoom-F6-NP-F-Repair/download/Zoom-F6-NP-F-Replacement-Main.STL) |
| CAD model | [.STEP ↓](./REPAIRS/Zoom-F6-NP-F-Repair/download/Zoom-F6-NP-F-Replacement.STEP) |
| Printer parameters | [.3MF ↓](./REPAIRS/Zoom-F6-NP-F-Repair/download/Zoom-F6-NP-F-Replacement.3mf) |

## How to Build

1. Disassemble the Movi Pro battery holder.
2. Keep all the PCB, covers and screws.
3. Print the replacement part.
4. Heat slightly the tabs of the part to bend them in position.
5. Install the PCB  
6. Install the PCB  
7. Screw the new battery holder to the Movi Pro
