Tome-Sulmont/docs-site/content/REPAIRS/Zoom F6/Tempo.md

---
draft: true
description:
---

Tags : npf, np-f, replacement, repair, repair part, rear panel, spare part

Main [.STL ↓](./REPAIRS/Zoom-F6-NP-F-Repair/download/Zoom-F6-NP-F-Replacement-Main.STL)
Tab [.STL ↓](./REPAIRS/Zoom-F6-NP-F-Repair/download/Zoom-F6-NP-F-Replacement-Tab.STL)
Complete part [.STEP ↓](./REPAIRS/Zoom-F6-NP-F-Repair/download/Zoom-F6-NP-F-Replacement.STEP)
Printer parameters [.3MF ↓](./REPAIRS/Zoom-F6-NP-F-Repair/download/Zoom-F6-NP-F-Replacement.3mf)
