Tome-Sulmont/docs-site/content/REPAIRS/Zoom F6/Zoom F6 NP-F Replacement.md

---
draft: false
description: 3D-printable replacement housing for a broken Zoom F6 NP-F battery holder.
---
## Intro
This page provides a 3D-printable replacement for the Zoom F6 NP-F battery holder. The design replaces the original injection-molded part while reusing the original electronic and mechanical components.

| ![[3d-printed-np-f-replacement-final.jpg\|450]] |
| :---------------------------------------------: |
|         *The replacement part in place*         |

| ![[3d-printed-np-f-replacement-back.jpg\|450]] | ![[3d-printed-np-f-replacement-pcb.jpg\|450]] |
| :---: | :---: |
| *Rear of the replacement part* |  *Original NP-F PCB on the replacement part*  |

## CAD

| ![[zoom-f6-np-f-iso-view-top.png\|CAD isometric view\|450]] |
| :---------------------------------------------------------: |
|                    *CAD Isometric view*                     |

## Download

| Component | File |
| --- | --- |
| Main part | [.STL ↓](./REPAIRS/Zoom-F6/download/Zoom-F6-NP-F-Replacement-Main.STL) |
| Tabs | [.STL ↓](./REPAIRS/Zoom-F6/download/Zoom-F6-NP-F-Replacement-Tab.STL)  |
| CAD model | [.STEP ↓](./REPAIRS/Zoom-F6/download/Zoom-F6-NP-F-Replacement.STEP) |
| Printer parameters | [.3MF ↓](./REPAIRS/Zoom-F6/download/Zoom-F6-NP-F-Replacement.3mf) |

## How to Build

1. Disassemble the Zoom F6 until you can remove the NP-F battery holder.
2. Keep all the original parts except the damaged injection-molded part.  
3. Print the replacement parts (the two tabs are printed separately).  
4. Glue the tabs to the main part using cyanoacrylate (super glue).  
5. Glue one of the original magnets into the replacement part.  
6. Install the door, PCB, and copper foil onto the replacement part.  
7. Reassemble the Zoom F6.
