Tome-Sulmont/docs-site/content/REPAIRS/Zoom F6/attachments/zoom-f6-np-f-iso-view-bottom.png

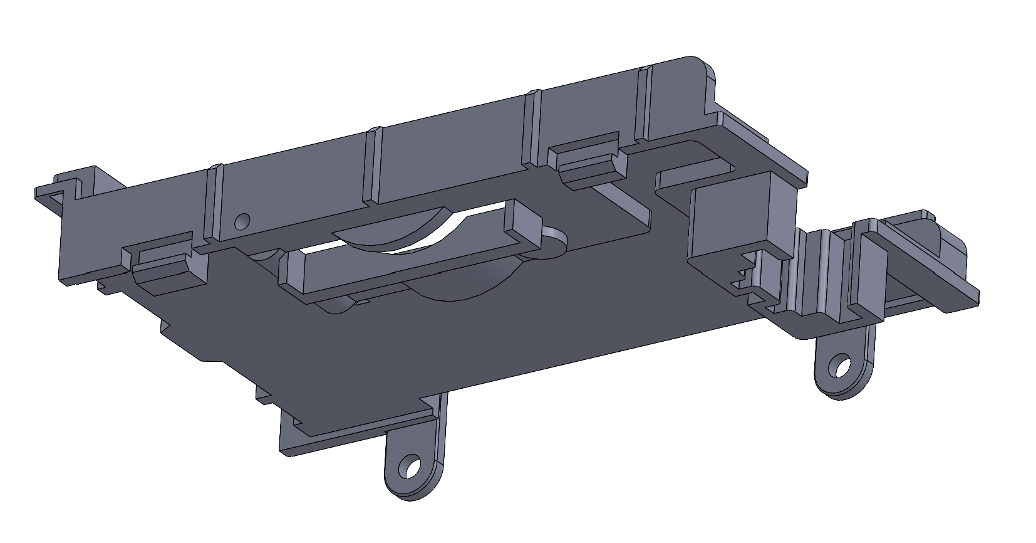
content/REPAIRS/Zoom F6/attachments/zoom-f6-np-f-iso-view-bottom.png
