Tome-Sulmont/docs-site/content/REPAIRS/Zoom F6/attachments/zoom-f6-np-f-iso-view-top2.png

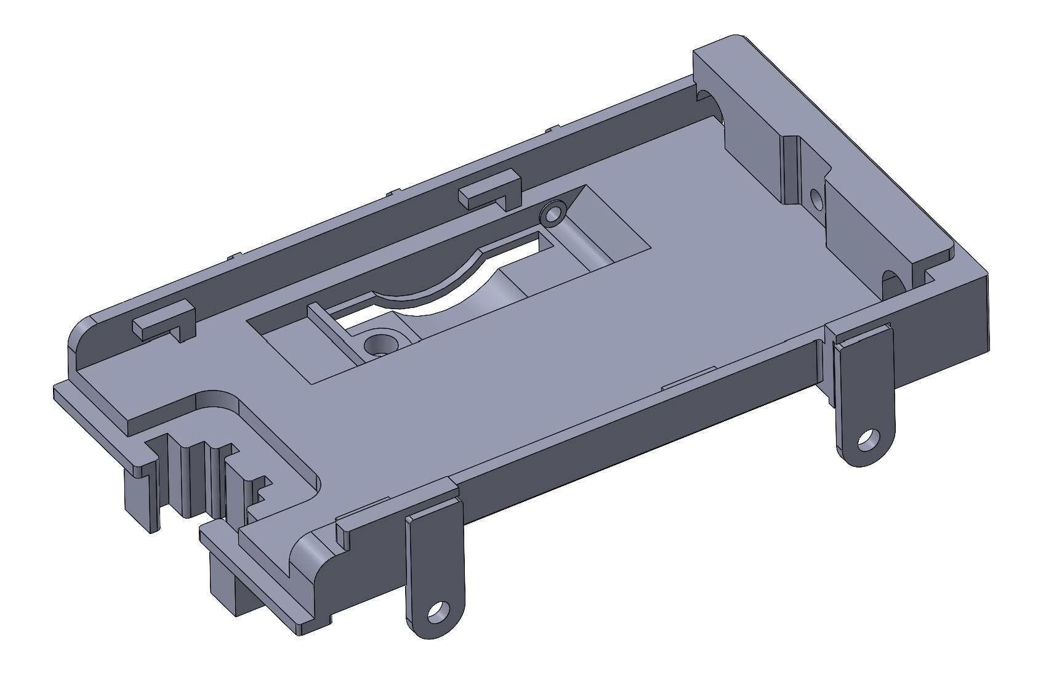
content/REPAIRS/Zoom F6/attachments/zoom-f6-np-f-iso-view-top2.png
