Tome-Sulmont/docs-site/content/REPAIRS/Zoom F6/attachments/zoom-f6-np-f-iso-view-top.png

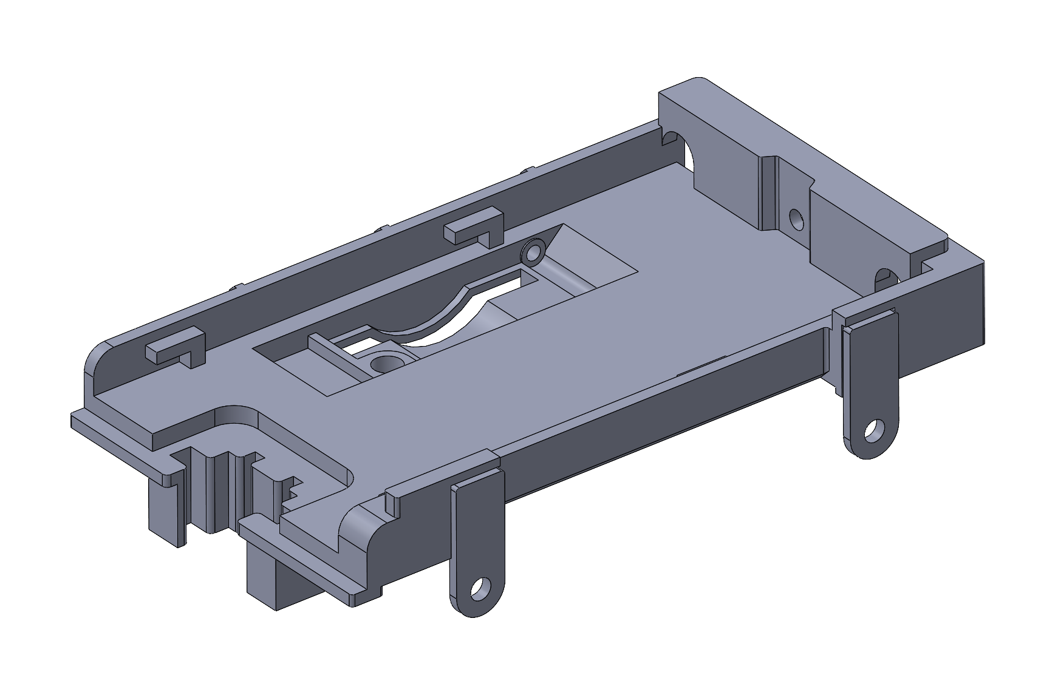
content/REPAIRS/Zoom F6/attachments/zoom-f6-np-f-iso-view-top.png
