Tome-Sulmont/docs-site/(commit log)

2026-02-02 Quartz sync: Feb 2, 2026, 8:45 PM
    [3d-printed-part.STEP]
2026-02-02 Quartz sync: Feb 2, 2026, 9:01 PM
    [3d-printed-part.3mf, 3d-printed-part.STL, LeicaM-FX-Adapter.STEP, URSA-Mini-B4-Mount.STEP]
2026-02-06 Quartz sync: Feb 6, 2026, 10:57 PM
    [Aluminium_lens_mount.STEP]
2026-02-06 Quartz sync: Feb 6, 2026, 11:05 PM
    [alu-lens-mount.STEP]
2026-02-09 Quartz sync: Feb 9, 2026, 11:32 PM
    [3d-printed-part.step.SLDPRT]
2026-06-29 Quartz sync: Jun 29, 2026, 10:08 PM
    [Zoom-F6-NP-F-Replacement-Main.STL, Zoom-F6-NP-F-Replacement-Tab.STL, Zoom-F6-NP-F-Replacement.3mf, Zoom-F6-NP-F-Replacement.STEP]
